felixharnstrom/KMM_2016_Kartrobot/doc/projektplan/tidsplanering.pdf

AKTIVITETER | TID | VEM | TIDPLAN (när), veckonummer
| Beskrivning
| Designspecifikation
| Protokoll mellan PC och robot
| PWM gränssnitt
| UART gränssnitt
| Gränssnitt för blåtandskommunikation
| Upprätta ett dataflöde mellan sensormodulen och sensorerna
| Implementera sensormätning för LIDAR
| Motorstyrning i styrmodul
| Servostyrning LIDAR-torn
| Gränssnitt mellan kontroll- och styrmodul
| Hantering och bearbetning av sensordata
| Protokoll och högnivåkommandon mellan kontroll- och styrmodul
| Test av sensormodul
| Gränssnitt mellan kontroll- och sensormodul
| Test av styrmodul
| Synka diagnostisk data från kommunikationsmodul till PC
| Filtrera mätvärden
| Implementation av manuell styrning
| Styralgoritm
| GUI till PC
| Rumsavskanning från stillastående
| Testa styralgoritm
| Test av GUI
| GUI karta
| Kartalgoritm
| Test av kartalgoritm och autonom styrning
| Navigeringsalgoritm (autonom styrning)
| Test av system
| Optimering
| Teknisk dokumentation
| Användarmanual
| Muntlig presentation (förberedelser)
Nr | timmar | Initialer | 38 | 39 | 40 | 41 | 42 | 43 | 44 | 45 | 46 | 47 | 48 | 49 | 50 | 51 | Sa
1 | 80 | Alla | | | 40 | 40 | O | | | | | | | | | | 80
2 | 10 | MV | | | | | M | | 10 | | | | | | | | 10
3 | 15 | DOK, HV | | | | | T | T | 15 | | | | | | | | 15
4 | 15 | PL, TST | | | | | E | E | 15 | | | | | | | | 15
5 | 10 | MV | | | | | N | N | 10 | | | | | | | | 10
6 | 15 | LEV | | | | | T | T | 15 | | | | | | | | 15
7 | 10 | DOK, HV | | | | | A | A | 10 | | | | | | | | 10
8 | 10 | DOK, HV | | | | | - | - | 10 | | | | | | | | 10
9 | 10 | DOK, HV | | | | | P | P | 10 | | | | | | | | 10
10 | 10 | PL, TST | | | | | | | 10 | | | | | | | | 10
11 | 26 | LEV, MV | | | | | | | | 26 | | | | | | | 26
12 | 20 | DOK, HV | | | | | | | | 20 | | | | | | | 20
13 | 10 | LEV, MV | | | | | | | | 10 | | | | | | | 10
14 | 15 | PL, TST | | | | | | | | 15 | | | | | | | 15
15 | 10 | DOK, HV | | | | | | | | 10 | | | | | | | 10
16 | 20 | PL, TST | | | | | | | | 20 | | | | | | | 20
17 | 15 | DOK, HV | | | | | | | | 10 | 5 | | | | | | 15
18 | 30 | DOK, HV, PL, MV | | | | | | | | | 30 | | | | | | 30
19 | 40 | DOK, HV, PL, MV | | | | | | | | | 40 | | | | | | 40
20 | 20 | LEV, TST | | | | | | | | | 18 | | 2 | | | | 20
21 | 40 | LEV, TST | | | | | | | | | 10 | 30 | | | | | 40
22 | 20 | DOK, HV | | | | | | | | | | 20 | | | | | 20
23 | 10 | DOK, MV | | | | | | | | | | 10 | | | | | 10
24 | 20 | PL, MV | | | | | | | | | | 20 | | | | | 20
25 | 50 | PL, HV | | | | | | | | | | 20 | 30 | | | | 50
26 | 30 | DOK, LEV | | | | | | | | | | | 30 | | | | 30
27 | 70 | MV, TST, PL | | | | | | | | | | | 30 | 40 | | | 70
28 | 40 | HV, DOK, LEV | | | | | | | | | | | | 40 | | | 40
29 | 20 | Alla | | | | | | | | | | | | 10 | 10 | | 20
30 | 64 | Alla | | | | | | | | | | | | 30 | 34 | | 64
31 | 30 | Alla | | | | | | | | | | | | | 30 | | 30
32 | 20 | Alla | | | | | | | | | | | | | | 20 | 20
33 | | | | | | | | | | | | | | | | | 0
34 | 95 | | | | | | | | 9 | 9 | 14 | 14 | 14 | 20 | 10 | 5 | 95
35 | | | | | | | | | | | | | | | | | 0
36 | | | | | | | | | | | | | | | | | 0
37 | 60 | Alla | | | 6 | 6 | | | 6 | 6 | 6 | 6 | 6 | 6 | 6 | 6 | 60
38 | | | | | | | | | | | | | | | | | 0
39 | | | | | | | | | | | | | | | | | 0
40 | | | | | | | | | | Fr | | | | | | | 0
41 | | | | | | | | | | | Fr | | | | | | 0
42 | | | | | | | | | | | | Fr | | | | | 0
43 | | | | | | | | | | | | | | On | | | 0
44 | | | | | | | | | | | | | | | | | 0
45 | | Alla | | | | | | | fr | | | | | | | | 0
46 | | | | | | | | | | | | | | | | | 0
47 | | TST, HV, MV | | | | | | | | | | | | | fr | | 0
48 | | PL, LEV, MV | | | | | | | | | | | | | | to | 0
49 | | | | | | | | | | | | | | | | | 0
50 | | | | | | | | | | | | | | | | | 0
51 | | | | | | | | | | | | | | | | | 0
| | 0 | 0 | 46 | 46 | 0 | 0 | 120 | 126 | 123 | 120 | 112 | 146 | 90 | 31 | 0 | 0 | 0 | 0 | 0 | 0 | 0 | 0 | 0
Summa antal timmar: | 960 | | | | | | | | | | | | | | | | | | | | | | | | 960

Beslutspunkt 3
Beslutspunkt 4 (Används ej) Beslutspunkt 5
Beslutspunkt 6

Projektmöten

Milstolpe 1: Roboten kan köra framåt (röra sig) Milstolpe 2: Roboten kan styras manuellt Milstolpe 3: Roboten kan köras autonomt Milstolpe 4: Roboten uppfyller kravspecen

Reservtid

Mattias Krysander | Version: | 1.0 | Felix Härnström 2016-09-24

## PLANERING

Projekt: | Kartrobot
Projektgrupp: | 1
Datum: | 2016-09-24 | Granskad:
Kurs: | TSEA29 | Utfärdare: | DM, EN, FH

Beställare:
