felixharnstrom/KMM_2016_Kartrobot/doc/projektplan/projektplan.tex

\documentclass[a4paper,11pt]{article}

\usepackage[utf8]{inputenc}
\usepackage[swedish]{babel}
\usepackage[top=1in,bottom=1in,left=1in,right=1in,headsep=.5in]{geometry}
\usepackage{hyperref}
\usepackage{graphicx}
\usepackage{longtable}
\usepackage{pdfpages}

\usepackage{array}
\newcolumntype{L}[1]{>{\raggedright\let\newline\\\arraybackslash\hspace{0pt}}m{#1}}
\newcolumntype{C}[1]{>{\centering\let\newline\\\arraybackslash\hspace{0pt}}m{#1}}
\newcolumntype{R}[1]{>{\raggedleft\let\newline\\\arraybackslash\hspace{0pt}}m{#1}}

\usepackage[yyyymmdd,hhmmss]{datetime}
\renewcommand{\dateseparator}{-}

\usepackage{mathptmx}    %Times Roman font
\usepackage{helvet}    %Helvetica, served as a model for arial
\usepackage{anyfontsize}

\usepackage[tocgraduated]{tocstyle}
\usetocstyle{allwithdot}

\usepackage[titletoc,title]{appendix}

\usepackage[backend=bibtex,style=authoryear,maxcitenames=2,maxbibnames=9]{biblatex}		%Harvard-style citations
\setlength{\bibitemsep}{\baselineskip}	%vertical space between bibliography items

\usepackage{fancyhdr}
\fancypagestyle{intro}{
    \fancyhf{}
    \fancyhead[C]{\LIPSprojekttitel}
    \fancyhead[R]{\today} 
    \fancyfoot[L]{\LIPSkursnamn \\ \LIPSdokumenttyp}
    \fancyfoot[C]{\phantom{text}\roman{page}}
    \fancyfoot[R]{\LIPSprojektgrupp \\ \LIPSgruppepost} 
    \renewcommand{\headrulewidth}{0.4pt}
    \renewcommand{\footrulewidth}{0.4pt}}
\fancypagestyle{content}{
    \fancyhf{}
    \fancyhead[C]{\LIPSprojekttitel}
    \fancyhead[R]{\today} 
    \fancyfoot[L]{\LIPSkursnamn \\ \LIPSdokumenttyp}
    \fancyfoot[C]{\phantom{text}\thepage}
    \fancyfoot[R]{\LIPSprojektgrupp \\ \LIPSgruppepost} 
    \renewcommand{\headrulewidth}{0.4pt}
    \renewcommand{\footrulewidth}{0.4pt}}

\usepackage{titlesec}
\titleformat{\section}
{\normalfont\sffamily\Large\bfseries}
{\thesection}{1em}{}
\titleformat{\subsection}
{\normalfont\sffamily\large\bfseries}
{\thesubsection}{1em}{}
\titleformat{\subsubsection}
{\normalfont\sffamily\bfseries}
{\thesubsubsection}{1em}{}

\newcommand{\LIPSartaltermin}{2016/HT}
\newcommand{\LIPSkursnamn}{TSEA29}
\newcommand{\LIPSprojekttitel}{Kartrobot}
\newcommand{\LIPSprojektgrupp}{Grupp 1}
\newcommand{\LIPSgruppepost}{\href{mailto:kmm_2016_grupp1@liuonline.onmicrosoft.com}{{\small kmm\_2016\_grupp1@liuonline.onmicrosoft.com}}}
\newcommand{\LIPSkund}{ISY, Linköpings universitet, 581\,83 Linköping}
\newcommand{\LIPSkundkontakt}{Mattias Krysander, 013-282198, matkr@isy.liu.se}
\newcommand{\LIPSkursansvarig}{Tomas Svensson, 013-281368, Tomas.Svensson@liu.se}
\newcommand{\LIPShandledare}{Olov Andersson, 013-282658, olov@isy.liu.se}
\newcommand{\LIPSdokumenttyp}{Projektplan}
\newcommand{\LIPSredaktor}{Felix Härnström}
\newcommand{\LIPSversion}{1.0}
\newcommand{\LIPSgranskare}{Silas Lenz}
\newcommand{\LIPSgranskatdatum}{2016-09-24}
\newcommand{\LIPSgodkannare}{}
\newcommand{\LIPSgodkantdatum}{}

\addbibresource{bibliography.bib}
\input{LIPS.tex}
\begin{document}

\pagestyle{intro}
\LIPStitelsida
\clearpage
\begin{LIPSprojektidentitet}
	\LIPSgruppmedlem{Hannes Haglund}{Designansvarig mjukvara (MV)}{hanha265@student.liu.se}
	\LIPSgruppmedlem{Felix Härnström}{Projektledare (PL)}{felha423@student.liu.se}
	\LIPSgruppmedlem{Jani Jokinen}{Leveransansvarig (LEV)}{janjo273@student.liu.se}
	\LIPSgruppmedlem{Silas Lenz}{Testansvarig (TST)}{sille914@student.liu.se}
	\LIPSgruppmedlem{Daniel Månsson}{Designansvarig hårdvara (HV)}{danma344@student.liu.se}
	\LIPSgruppmedlem{Emil Norberg}{Dokumentansvarig (DOK)}{emino969@student.liu.se}
\end{LIPSprojektidentitet}
\clearpage
\renewcommand{\familydefault}{\sfdefault}	%Sans-serif
\normalfont
\tableofcontents
\renewcommand{\familydefault}{\rmdefault}	%Back to serifs
\normalfont
\clearpage
\begin{LIPSdokumenthistorik}
    \LIPSversionsinfo{1.0}{2016-09-24}{Upphöjt till version 1.0}{FH, DM}{SL}
	\LIPSversionsinfo{0.1}{2016-09-22}{Första utkastet}{FH, JJ, SL}{EN}
\end{LIPSdokumenthistorik}
\clearpage
\setcounter{page}{1}
\pagestyle{content}
\section{Beställare}
Beställare är Mattias Krysander från ISY vid Linköpings universitet.

\section{Översiktlig beskrivning av projektet}
\subsection{Syfte och mål}
Projektets mål är att utefter givet projektdirektiv och med beställaren överenskommen kravspecifikation utveckla en robot som kan genomsöka och kartlägga ett enkelt rum. Utöver roboten ska en medföljande PC-mjukvara levereras som kan styra roboten och visa realtidsdata såsom diagnostik och kartan över rummet.

\subsection{Leveranser}
LEV ansvarar för att alla leveranser sker inom utsatt tid. 

\begin{flushleft}
	\begin{LIPSleveransplan}
		\LIPSplaneradleverans{Projektplan, tidsplan, och systemskiss}{PL}{Första version av projektplan, tidsplan, och systemskiss}{2016-09-22}
		\LIPSplaneradleverans{Projektplan, tidsplan, och systemskiss}{PL}{Slutgiltig version av projektplan, tidsplan, och systemskiss}{2016-09-30}
		\LIPSplaneradleverans{Tidrapport}{PL}{Tidrapport 1.}{2016-10-31}
		\LIPSplaneradleverans{Designspecifikation}{MV, HV}{Första version av designspecifikationen.}{2016-11-01}
		\LIPSplaneradleverans{Designspecifikation}{MV, HV}{Slutgiltig version av designspecifikation.}{2016-11-04}
		\LIPSplaneradleverans{Tidrapport}{PL}{Tidrapport 2.}{2016-11-7}
		\LIPSplaneradleverans{Tidrapport}{PL}{Tidrapport 3.}{2016-11-14}
		\LIPSplaneradleverans{Tidrapport}{PL}{Tidrapport 4.}{2016-11-21}
		\LIPSplaneradleverans{Tidrapport}{PL}{Tidrapport 5.}{2016-11-28}
		\LIPSplaneradleverans{Tidrapport}{PL}{Tidrapport 6.}{2016-12-5}
		\LIPSplaneradleverans{Tidrapport}{PL}{Tidrapport 7.}{2016-12-12}
		\LIPSplaneradleverans{Teknisk dokumentation och användarhandledning}{DOK}{Teknisk dokumentation och användarhandledning ska vara inlämnad.}{3 arbetsdagar före redovisning.}
		\LIPSplaneradleverans{Verifiering av kraven (BP5).}{TST}{Tillsammans med beställaren fattas beslut huruvida projektet har nått målet.}{Senast dagen innan redovisning.}
		\LIPSplaneradleverans{Tidrapport}{PL}{Tidrapport 8.}{2016-12-19}
		\LIPSplaneradleverans{Slutpresentation}{PL}{Muntlig presentation av projektet.}{2016-12-19}
		\LIPSplaneradleverans{Tävlingsdeltagande}{PL}{Tävla mot andra robotar som har byggts i kursen.}{2016-12-20}
		\LIPSplaneradleverans{Efterstudie}{PL}{Efterstudie ska lämnas till beställaren.}{2016-12-21}
		\LIPSplaneradleverans{Källkod}{MV}{Källkod ska lämnas till beställaren.}{2016-12-21}
		\LIPSplaneradleverans{Utrustning}{HV}{All utrustning ska återlämnas.}{2016-12-22}
	\end{LIPSleveransplan}
\end{flushleft}

\subsection{Begränsningar}
Produkten är vid slutleverans begränsad till de krav som är formulerade i den senaste versionen av kravspecifikationen. Kravspecifikationen kan inte uppdateras utan överenskommelse med beställaren.

\section{Fasplan}
\subsection{Före projektstart}
Innan påbörjad projektstart ska en kravspecifikation tas fram med utgång i projektdirektivet. Ansvarsområden ska bestämmas internt inom projektgruppen. Projektgruppen ska producera en projektplan, tidsplan, samt systemskiss utefter givna resurser.

\subsection{Under projektet}
I början av denna fas ska en designspecifikation tas fram och godkännas av beställare. Under projektets gång ska projektgruppen utgå från designspecifikationen och se till att överenskomna leveranser sker tidsenligt. Projektet ska utföras enligt LIPS-modellen.

\subsection{Efter projektet}
Efter beslutspunkt 5 ska produkten levereras med tillhörande dokumentation. Beställaren utför acceptanstest i samband med en tävling där alla robotar som har producerats utefter samma projektdirektiv ska ställa upp. En efterstudie ska därefter levereras.

\section{Organisationsplan för hela projektet}
Projektgruppen och utomstående resurser är organiserade såsom beskrivet i figur \ref{fig:org}. Utöver denna grova organisationsplan kan projektgruppen bilda interna arbetsgrupper vid behov.

\begin{figure}[h!]
	\centering
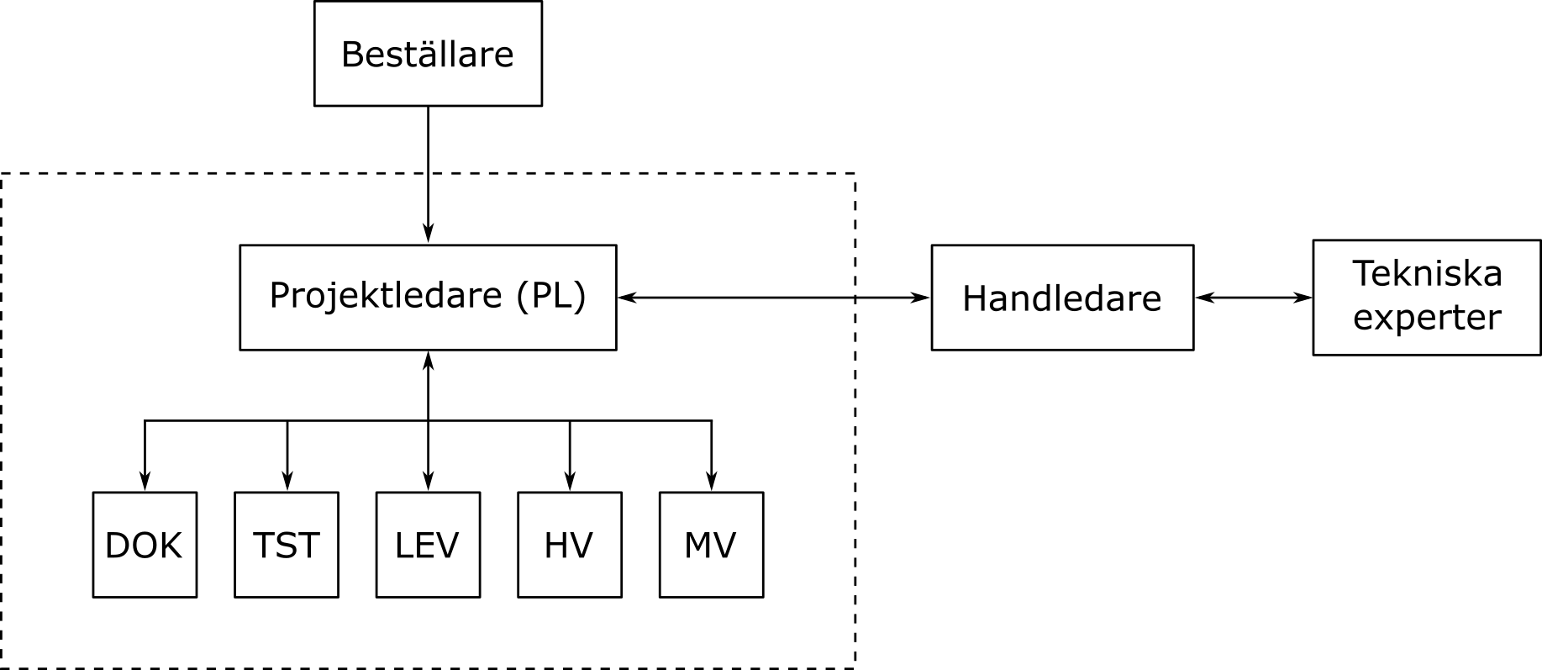
[picture p23: doc/projektplan/organisation.png]
	
	\caption{Översiktlig projektorganisation.}
	\label{fig:org}
\end{figure}

\subsection{Villkor för samarbetet inom projektgruppen}
Följande punkter har beslutats gemensamt av projektgruppen och ska anses vara riktlinjer för hur samarbetet inom gruppen ska ske. Övriga frågor ska tas upp internt på gruppmöten.

\begin{itemize}
	\item Deltagarna i gruppen ska gemensamt göra upp ordningsregler för gruppen om tider, närvaro, förberedelser, etc.
	\item Alla deltagare i gruppen ska delta vid de tillfällen som gruppen kommit överens om.
	\item Alla deltagare i gruppen ska komma väl förberedda till möten och dylikt, i den mån att det är nödvändigt för gruppens fortsatta arbete.
	\item Alla deltagare i gruppen förväntas självständigt kommunicera med övriga gruppmedlemmar och arbetsgrupper för att underlätta sina egna och övrigas arbetsuppgifter.
	\item Alla deltagare i gruppen ska ha en professionell inställning till arbetet som ska utföras.
	\item Alla deltagare i gruppen kan ta upp interpersonella konflikter och frågor på möten för att säkerställa ett hälsosamt samarbete.
	\item Problem med deltagare som inte bidrar till det gemensamma arbetet ska i första hand lösas internt, men kan vidarebefordras till kurspersonal om problemet kvarstår.
	\item Alla deltagare i gruppen ska vara öppna för konstruktiv kritik.
	\item Grupparbetet ska prioritera intresse framför resultat. En gruppmedlem ska inte vara tvingad att arbeta med någon visst område enbart för att vederbörande är den bäst lämpade för arbetet.
	\item Vid schemalagda arbetstillfällen och projektmöten ska 'akademisk kvart' tillämpas.
	\item Alla deltagare i gruppen har möjlighet att jobba hemifrån utefter eget schema efter samröre med berörda gruppmedlemmar.
	\item Alla deltagare i gruppen ska vara kontaktbara under schemalagd arbetstid.
\end{itemize}

\subsection{Definition av arbetsinnehåll och ansvar}
\subparagraph{Projektledare (PL)}
\begin{itemize}
\item Ansvarig för kontakt mellan gruppen och beställaren samt handledaren.
\item Ansvarar för att uppdatera och i tid skicka in tidsrapporterna.
\item Ska se till att mötesplanen följs och kallar till varje möte.
\item Ska fördela arbetsuppgifter internt.
\item Ska hålla en överblick över projektet och se till att alla gruppmedlemmar jobbar mot samma mål.
\end{itemize}

\subparagraph{Leveransansvarig (LEV)}
\begin{itemize}
\item Ansvarig för att alla leveranser sker inom utsatt tid.
\item Ansvarig för att fördela bufferttid från tidsplanen.
\item Ansvarig för att revidera tidsplanen vid behov.
\item Ska informera alla gruppmedlemmar vid eventuellt behov av att revidera tidsplanen.
\end{itemize}

\subparagraph{Testansvarig (TST)}
\begin{itemize}
\item Ansvarig för att tester utförs.
\item Ansvarig för att producera rutiner för att utföra tester och för att rapportera resultatet av dessa.
\item Ska samarbeta med HV och MV för att utforma integrationstestspecifikation och systemtestspecifikation. 
\end{itemize}

\subparagraph{Dokumentansvarig (DOK)}
\begin{itemize}
\item Ansvarig för att alla dokument som ska levereras följer LIPS-mallar i största möjliga mån.
\item Ska vid behov producera dokumentmallar i fallet att LIPS-mall saknas.
\item Ansvarig för att mötesprotokoll förs.
\item Ska informera alla gruppmedlemmar om gällande stilregler för dokument som ska levereras.
\end{itemize}

\subparagraph{Designansvarig hårdvara (HV)}
\begin{itemize}
\item Ansvarig för övergripande kvalitet på den hårdvara gruppen producerar.
\item Ansvarig för att upprätta rutiner och en standard för hur hårdvarukonstruktionen ska utföras.
\item Ansvarig för att gruppen har de hårdvaruverktyg den behöver.
\item Ska samarbeta med TST för att utforma integrationstestspecifikation och systemtestspecifikation.
\item Ansvarig för att hårdvaran förvaras säkert.
\end{itemize}

\subparagraph{Designansvarig mjukvara (MV)}
\begin{itemize}
\item Ansvarig för övergripande kvalitet på den mjukvara gruppen producerar.
\item Ansvarig för att gruppen har de mjukvaruverktyg den behöver.
\item Ska samarbeta med TST för att utforma integrationstestspecifikation och systemtestspecifikation.
\item Ansvarig för att utforma rutiner för versionshantering av källkod.
\end{itemize}

\section{Dokumentplan}
\label{sec:doc_plan}
Dokument ska i största möjliga mån följa tillgängliga LIPS-mallar. Dokumentansvarig är i fall där LIPS-mall saknas ansvarig för att skapa eller i övrigt godkänna dokumentmallar vid behov. Dokument ska lagras på sådant sätt att alla gruppmedlemmar har tillgång till alla dokument över internet. Alla dokument ska skrivas på svenska, men teknisk dokumentation i källkod bör skrivas på engelska. 

Dokument ska revisionsnumreras på formatet \textit{\textless version\textgreater .\textless utgåva\textgreater}, där versionsnummer under 0 ska anses vara interna utkast, och version 1 är redo för leverans eller arkivering beroende på dokumenttyp. Att tilldela ett nytt versionsnummer innebär stora förändringar till dokumentets väsentliga innehåll. Utgåvenumret betecknar mindre förändringar som inte ändrar dokumentets väsentliga innehåll. Alla nya revisioner efter 1.0 av dokument som ska levereras till beställare måste göras i samröre med denne.

Alla gruppmedlemmar är ansvariga för att all dokumentation denne producerar följer de språkregler som gäller för dokumentspråket såsom beskrivet i tabell \ref{tab:documents}. För svenska gäller språkreglerna såsom beskrivna i \citetitle{Sprakradet2008} (\cite{Sprakradet2008}). För dokument som skrivs på engelska hänvisas till \citetitle{Ritter2003} (\cite{Ritter2003}).

%TODO: Tagit bort syfte och distribueras till. Känns onödigt och förstör tabellen.../SL
\label{tab:documents}
\begin{flushleft}
    \begin{tabular}{|L{90pt}|L{40pt} |L{60pt} |L{100pt} |L{100pt} |}
    	\hline
    	Dokument              & Ansvarig & Godkänns av & Distribueras till   & Färdig                         \\ \hline
    	Systemskiss           & PL       & Beställare  & Beställare, Gruppen & 2016-09-30                     \\ \hline
    	Tidsplan              & PL       & Beställare  & Beställare, Gruppen & 2016-09-30                     \\ \hline
    	Projektplan           & PL       & Beställare  & Beställare, Gruppen & 2016-09-30                     \\ \hline
    	Tidsrapporter         & PL      & Beställare  & Beställare, Gruppen & Måndagar vecka 44 - vecka 51   \\ \hline
    	Uppdaterad tidsplan   & DOK      & Beställare  & Beställare, Gruppen & Måndagar vecka 44 - vecka 51   \\ \hline
    	Designspecifikation   & MV, HV   & Handledare  & Handledare, Gruppen & 2016-11-04                     \\ \hline
    	Teknisk dokumentation & DOK      & Beställare  & Beställare, Gruppen & 3 arbetsdagar före redovisning \\ \hline
    	Användahandledning    & DOK      & Beställare  & Beställare, Gruppen & 3 arbetsdagar före redovisning \\ \hline
    	Efterstudie           & PL       & Beställare  & Beställare, Gruppen & 2016-12-21                     \\ \hline
    \end{tabular}
\end{flushleft}

\section{Utbildningsplan}
\subsection{Egen utbildning}
Alla gruppmedlemmar ska genomföra en laboration i mätteknik, vilket innefattar att lära sig att använda en logikanalysator. Utöver detta förväntas alla gruppmedlemmar egenhändigt söka upp den kunskap och utbildning som krävs för att utföra sina tilldelade arbetsuppgifter.

\section{Rapporteringsplan}
Tidsrapporter kommer att skrivas så att beställaren kan få en bild av hur projektet löper framåt, samt om tidsplanen följs. Se avsnitt \ref{sec:doc_plan} för detaljer om hur tidsrapporter ska utformas och levereras.

\section{Mötesplan}
För alla möten gäller att projektledaren kallar till möte efter samråd om tillfälle med övriga gruppmedlemmar. Mötesprotokoll ska föras utefter LIPS-mallen. Alla gruppmedlemmar kan föra protokoll, men mötesprotokoll måste godkännas av projektledare eller dokumentansvarig.

Regelbundna projektmöten ska ske veckovis, företrädesvis i början av varje vecka. Vid dessa möten ska den gångna veckans arbete redovisas och utvärderas. Vidare ska en plan för grupparbetet fram tills nästa möte beslutas. Dessa möten ska hållas korta, helst under en timme per mötestillfälle. 

Utöver dessa projektmöten kan alla gruppmedlemmar föreslå möten vid behov. Dessa möten kan exempelvis handla om att fånga upp problem så tidigt som möjligt, eller göra en funktionalitets- eller kodgenomgång.

\section{Resursplan}
Här beskrivs vilka personer som jobbar med projektet, samt deras uppgifter. Även ekonomi, lokaler, samt nödvändigt materiel kommer att behandlas i detta kapitel.

\subsection{Personer}
Projektmedlemmarna:
\begin{itemize}
	\item Felix Härnström, Projektledare (PL)
	\item Emil Norberg, Dokumentansvarig (DOK)
	\item Hannes Haglund, Designansvarig mjukvara (MV)
	\item Daniel Månsson, Designansvarig hårdvara (HV)
	\item Silas Lenz, Testansvarig (TST)
	\item Jani Jokinen, Leveransansvarig (LEV)
\end{itemize}
Hannes Haglund kommer att vara bortrest under sista veckan av projektet, från och med den 20:e.

Schemalagd tid är prioriterat för arbete och samtliga deltagare är upptagna under andra kursers föreläsningar och moment.

Handledaren för projektet är Olov Andersson, som under projektets gång kommer vara tillgänglig för rådgivning. Projektgruppen kommer träffa handledaren mindre i början och mer i slutet av projektet.

Beställaren för projektet är  Mattias Krysander på ISY, Linköpings Universitet. Mattias kommer att delta vid alla beslutspunkter.

\subsection{Materiel}
Beställaren förser gruppen med den hård- och mjukvara som krävs för att genomföra projektet. Gruppen kan i samröre med beställare göra förfrågan om att införskaffa ytterligare materiel. 

\subsection{Lokaler}
Gruppen har tillgång till två arbetsstationer i laborationsytan MUXEN och där kan vid behov samtliga 6 medlemmar jobba. Vid behov kan även grupplokaler bokas kostnadsfritt på universitetet.

\subsection{Ekonomi}
Gruppen ska efter beslutspunkt 2 arbeta totalt 960 timmar, 160 timmar per person. Genomfört arbete ska redovisas veckovis till beställaren. Alla monetära utgifter står Linköpings Universitet för.

\section{Milstolpar och beslutspunkter}
I detta kapitel förklaras vilka milstolpar samt beslutspunkter som finns.

\subsection{Milstolpar}
\begin{flushleft}
    \begin{LIPSmilstolpar}
        \LIPSmilstolpe{1}{Roboten kan röra sig framåt.}{2016-11-11}
        \LIPSmilstolpe{2}{Roboten kan styras manuellt.}{2016-11-18}
        \LIPSmilstolpe{3}{Roboten kan köras autonomt.}{2016-11-25}
        \LIPSmilstolpe{4}{Roboten uppfyller kravspecen.}{2016-12-07}
    \end{LIPSmilstolpar}
\end{flushleft}

\subsection{Beslutspunkter}
\begin{flushleft}
	\begin{LIPSbeslutspunkter}
		\LIPSbp{0}{Godkännande av projektet, beslut startar förstudie}{2016-09-01}
		\LIPSbp{1}{Godkännande av kravspecifikation, beslut startar förberedelsefasen}{2016-09-13}
		\LIPSbp{2}{Godkännande av projektplan, tidsplan och systemskiss, beslut startar utförandefasen}{2016-09-30}
		\LIPSbp{3}{Godkännande av designspecifikation, beslut att fortsätta utförandefasen}{2016-11-04}
		\LIPSbp{4}{Används ej}{}
		\LIPSbp{5}{Verifiering av kraven, samt godkännande av produktens funktionalitet, beslut leder till leveransfasen}{Senast en dag innan presentation}
		\LIPSbp{6}{Godkännande av produktleverans, samt presentation och demonstration, leder till beslut att upplösa projektgruppen}{Vecka 51}
	\end{LIPSbeslutspunkter}
\end{flushleft}

\section{Aktiviteter}

\begin{flushleft}
    \begin{LIPSaktivitetslista}
        \LIPSaktivitet{1}{Designspecifikation}{Skriva en fullständig designspecifikation för användning i projektfasen.}{-}{80}
        \LIPSaktivitet{2}{Protokoll mellan PC och robot}{Upprätta protokollet för att överföra data över blåtand mellan PC och robot.}{1}{10}
        \LIPSaktivitet{3}{PWM gränssnitt}{Skriv ett gränssnitt för att kommunicera över PWM och anpassa det även för användning i kommunikation mellan sensormodul och ultraljudssensorer.}{1}{15}
        \LIPSaktivitet{4}{UART gränssnitt}{Skriv ett gränssnitt för att kommunicera över UART.}{1}{15}
        \LIPSaktivitet{5}{Gränssnitt för blåtands-kommunikation}{Implementera funktionalitet för att skicka och behandla kommandon mellan PC och kommunikationsmodul.}{2}{10}
        \LIPSaktivitet{6}{Upprätta ett dataflöde mellan sensormodulen och sensorerna}{Implementera kommunikation mellan sensormodulen och sensorerna.}{3, 7}{15}
        \LIPSaktivitet{7}{Implementera sensormätning för LIDAR}{Implementera funktionalitet så att vi kan läsa av värden från LIDAR-tornets sensor.}{3}{10}
        \LIPSaktivitet{8}{Motorstyrning i styrmodul}{Implementera funktionalitet för att styra vänster och höger motorsida i styrmodulen.}{3}{10}
        \LIPSaktivitet{9}{Servostyrning LIDAR-torn}{Funktionalitet för att styra LIDAR-tornets servo i styrmodulen.}{4}{10}
        \LIPSaktivitet{10}{Gränssnitt mellan kontroll- och styrmodul}{Implementera gränssnitt för USB-UART mellan kontrollmodul och styrmodul.}{4}{10}
        \LIPSaktivitet{11}{Hantering och bearbetning av sensordata}{Kontrollera att den sensordata som fås är vettig för att sedan behandla den och göra den användbar för kontrollmodulen.}{6}{26}
        \LIPSaktivitet{12}{Protokoll och högnivå-kommandon mellan kontroll- och styrmodul}{Implementera styrning av motorerna med hjälp av högnivåkommandon från kontrollmodulen och återkoppla med motordata.}{8, 9, 10}{20}
        \LIPSaktivitet{13}{Test av sensormodul}{Testa och verifiera att mätvärden från sensormodulen är korrekta och användbara för kontrollmodulen.}{11}{10}
        \LIPSaktivitet{14}{Gränssnitt mellan kontroll- och sensormodul}{Implementera gränssnitt för USB-UART mellan kontrollmodul och sensormodul.}{4, 13}{15}
        \LIPSaktivitet{15}{Test av styrmodul}{Testa och verifiera att styrmodulen är pålitlig vid styrning från kontrollenhet.}{12}{10}
        \LIPSaktivitet{16}{Synka diagnostisk data från kommunikationsmodul till PC}{Skriv funktionalitet för att kontinuerligt skicka diagnostisk data från kommunikationsmodul till PC.}{5, 12, 14}{20}
        \LIPSaktivitet{17}{Filtrera mätvärden}{Behandla sensordata i sensormodulen mer ingående för att förhindra felaktiga mätvärden.}{16}{15}
        \LIPSaktivitet{18}{Implementation av manuell styrning}{Möjliggör manuell styrning av roboten med hjälp av blåtandskommandon.}{5, 15}{30}
        \LIPSaktivitet{19}{Styralgoritm}{Autonom styrning för att kunna köra runt i rummet utan att krocka. Följa en vägg. Involverar även att fästa den manuella switchen för att byta mellan det manuella och autonoma körläget.}{18, 14}{40}
        \LIPSaktivitet{20}{GUI till PC}{Presentera diagnostisk data och möjliggör manuell styrning med ändring av parametrar från ett grafiskt användargränssnitt.}{16, 18}{20}
        \LIPSaktivitet{21}{Rumsavskanning från stillastående}{Funktionalitet som stödjer att skanna av rummet och bilda en karta då roboten står still.}{17}{40}
        \LIPSaktivitet{22}{Testning av styralgoritm}{Testa körning av roboten på autonomt läge och kontrollera att den inte krockar med någon vägg.}{19}{20}
        \LIPSaktivitet{23}{Test av GUI}{Kontrollera att GUI:t får korrekt data och är responsivt.}{20}{10}
        \LIPSaktivitet{24}{GUI karta}{Presentera grafiskt det rum som roboten har kartlagt.}{23, 25}{20}
        \LIPSaktivitet{25}{Kartalgoritm}{Funktionalitet för att skanna rummet och bearbeta data så att den blir presentabel och redo för att skickas till en PC.}{21, 22}{50}
        \LIPSaktivitet{26}{Test av kartalgoritm och autonom styrning}{Kontrollera och verifiera att det inte blir outforskade områden i kartan samt att den autonoma styrningen fungerar.}{24, 27}{30}
        \LIPSaktivitet{27}{Navigeringsalgoritm (autonom styrning)}{Utöka den autonoma styrningen med funktionalitet som med utgångspunkt från den befintliga kartan bestämmer vart den ska köra för att skanna mer.}{25}{70}
        \LIPSaktivitet{28}{Test av system}{Utförliga tester av roboten för att säkerställa att dess funktionalitet är pålitlig.}{26}{40}
        \LIPSaktivitet{29}{Optimering}{Optimera och testa roboten inför tävlingen i mån av tid.}{28}{20}
        \LIPSaktivitet{30}{Teknisk dokumentation}{Skriva en fullständig teknisk dokumentation för roboten.}{28}{64}
        \LIPSaktivitet{31}{Användar-manual}{Skriva en manual för hur roboten ska användas för kunden.}{28}{30}
        \LIPSaktivitet{32}{Muntlig presentation}{Förberedelser inför den muntliga presentationen av roboten.}{28}{20}
    \end{LIPSaktivitetslista}
\end{flushleft}
\section{Tidplan}
Se bilaga \ref{app:tidplan}.

\section{Förändringsplan}
% TODO: Kanske nämna leveransansvarigs roll i detta
Om projektet inte kan hålla den fastslagna tidsplanen ska tidsplanen revideras och projektgruppen ska ta interna åtgärder för att säkerställa tidsenliga leveranser trots förseningen. Beslut om reviderad tidsplan ska ske vid varje veckomöte. Om en försening riskerar att försena en leverans ska detta diskuteras med beställaren.

\section{Kvalitetsplan}
I denna sektion beskrivs rutiner gällande granskningar av dokument och tester som ska utföras på den hård- och mjukvara som produceras under projektets gång. Dessa aktiviteter ska utföras löpande under projektets gång för att minimera oförutsedda problem.

\subsection{Granskningar}
Alla dokument som ska levereras till beställare ska granskas av någon annan gruppmedlem än dokumentets redaktör såsom specificerat i sektion \ref{sec:doc_plan}. I första hand ska granskningen utföras av en gruppmedlem som har arbetat med sakfrågan som beskrivs i dokumentet.

\subsection{Testplan}
Alla gruppmedlemmar är ansvariga för att själva utföra enhetstester på all hård- och mjukvara som denne producerar. Testansvarig är ansvarig för att detta efterföljs och att det finns rimliga testprotokoll för alla delar av projektet. Testansvarig ska också säkerställa att det finns rutiner för hur misslyckade tester ska utvärderas och rapporteras. Testansvarig ska i samarbete med hårdvaruansvarig och mjukvaruansvarig utforma relevant integrationstestspecifikation och systemtestspecifikation.

\section{Prioriteringar}
I fallet att projektet drabbas av tidsnöd som riskerar att påverka tidsenliga leveranser ska detta i första hand diskuteras internt inom gruppen. Om en konkret handlingsplan för att säkerställa tidsenliga leveranser ej kan fastställas ska beställaren kontaktas för en dialog om att revidera kravspecifikationen.

\section{Projektavslut}
Projektet avslutas med en presentation av vår kartrobot, samt uppvisning av den i form av ett tävlingsdeltagande. Därefter ska allt material återlämnas till handledare. Dokumentationen ska lämnas till Linköpings Universitet för förvaring och alla medlemmar i gruppen få egna kopior för privat förvaring. När projektet är avslutat ska det utvärderas inom gruppen innan gruppen officiellt upplöses.

\clearpage

\begin{appendices}
\includepdf[scale=1.2,offset=45pt 100pt,pagecommand=\section{Tidplan}\label{app:tidplan}]{tidsplanering.pdf}
\end{appendices}
\clearpage
\addcontentsline{toc}{section}{Referenser}	%append references section at this location to TOC
\printbibliography
\end{document}
