felixharnstrom/KMM_2016_Kartrobot/doc/tek_dok/autonomt_flowchart.png

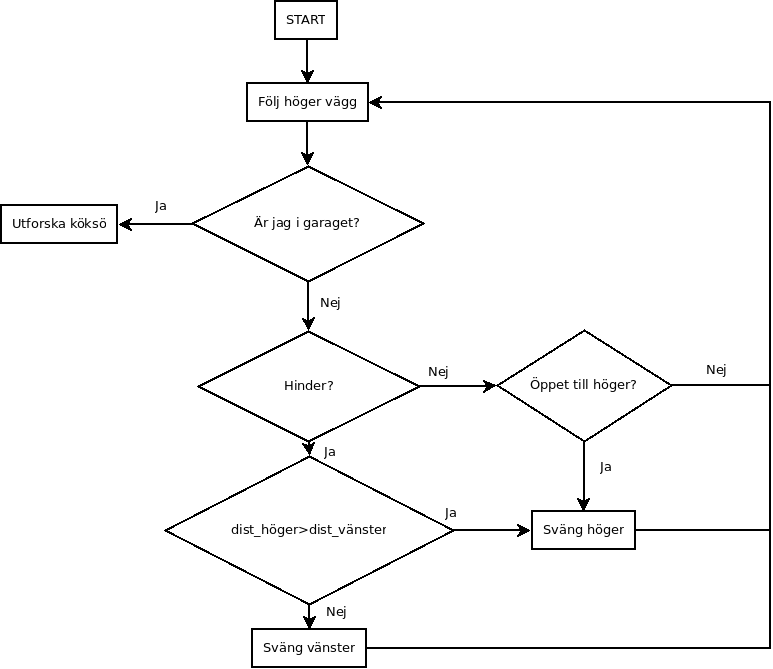
doc/tek_dok/autonomt_flowchart.png
