felixharnstrom/KMM_2016_Kartrobot/doc/tek_dok/layout_topdown.png

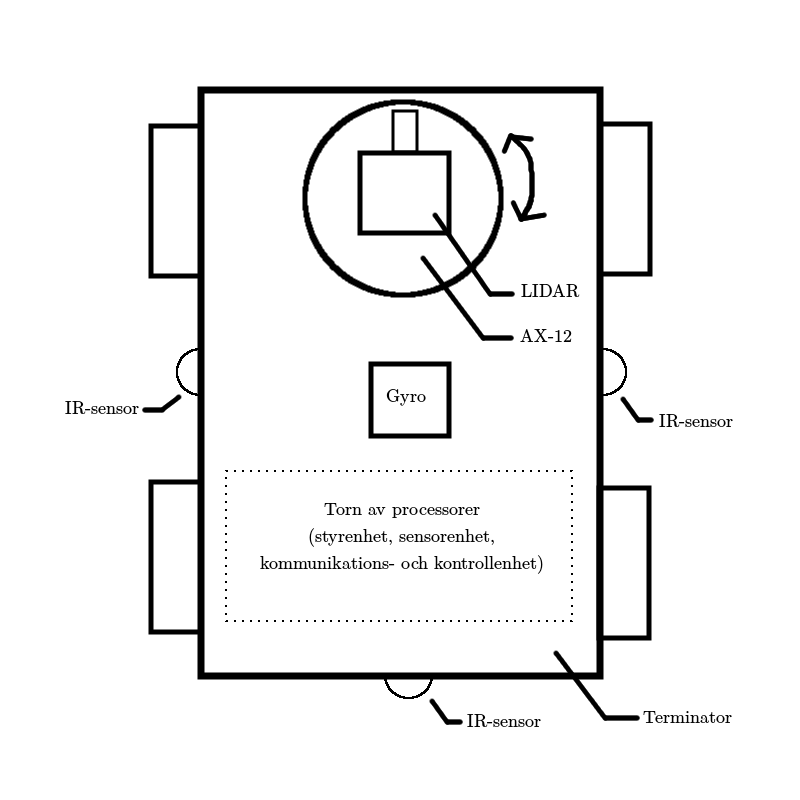
doc/tek_dok/layout_topdown.png
