felixharnstrom/KMM_2016_Kartrobot/doc/tek_dok/robot_overview.JPG

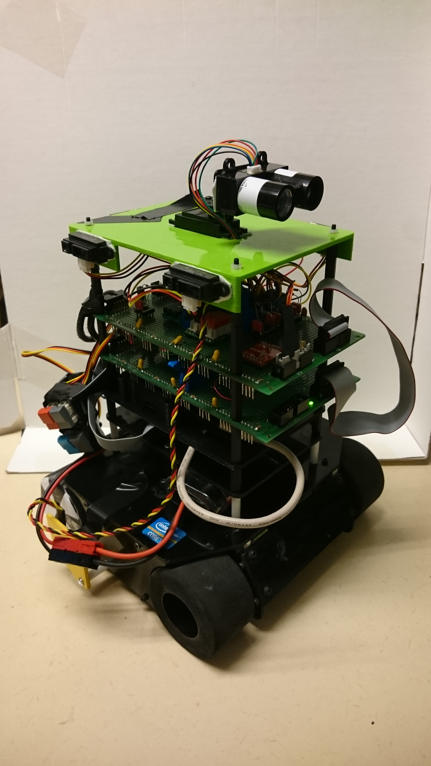
doc/tek_dok/robot_overview.JPG
