felixharnstrom/KMM_2016_Kartrobot/doc/tek_dok/robot_side.JPG

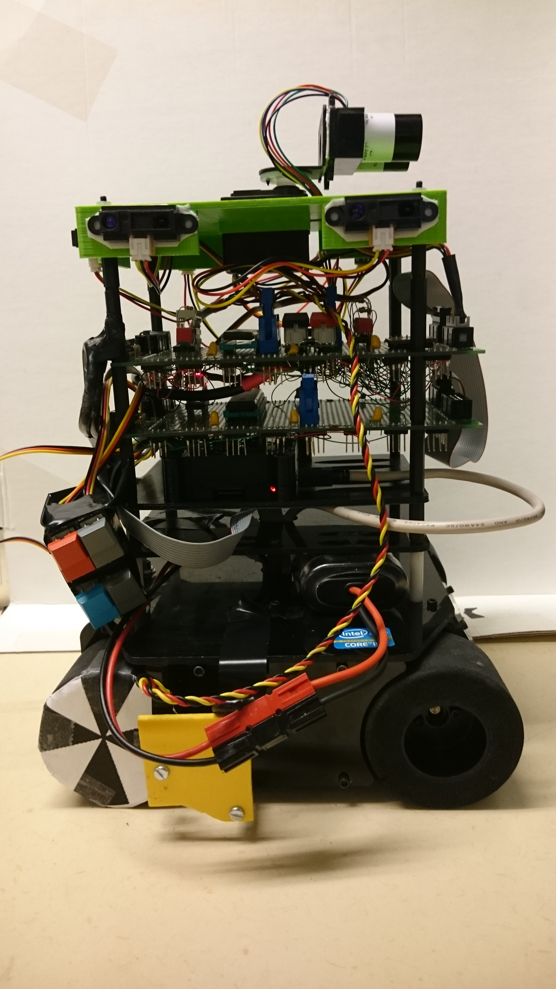
doc/tek_dok/robot_side.JPG
