felixharnstrom/KMM_2016_Kartrobot/doc/tek_dok/sensorenheten-flow_chart.jpg

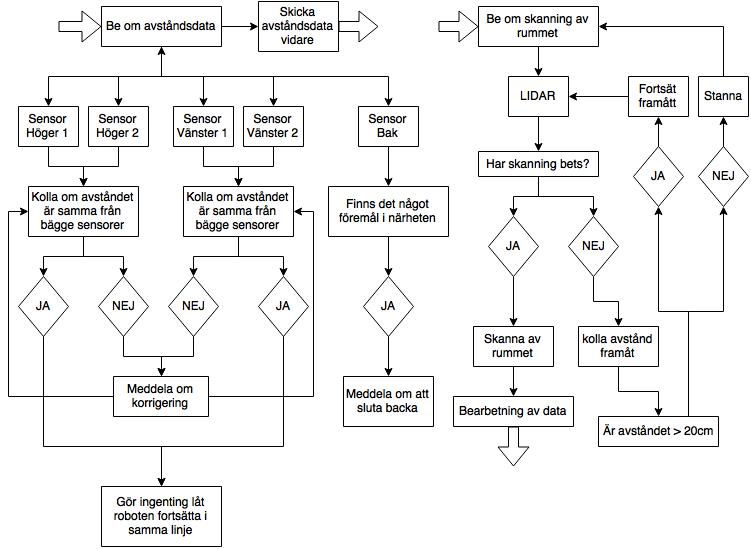
doc/tek_dok/sensorenheten-flow_chart.jpg
