felixharnstrom/KMM_2016_Kartrobot/doc/tek_dok/sensorenheten-flow_chart.png

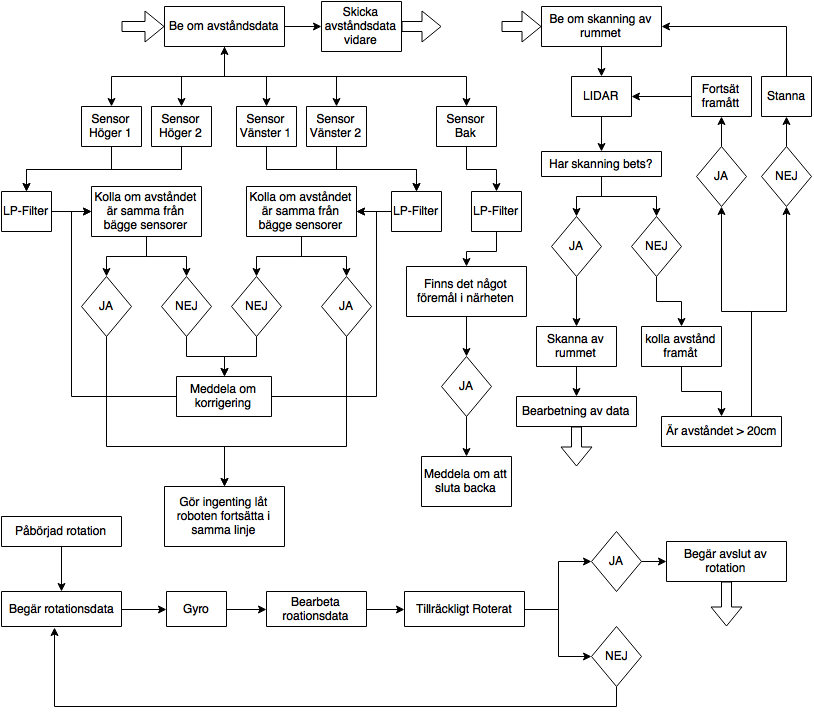
doc/tek_dok/sensorenheten-flow_chart.png
