felixharnstrom/KMM_2016_Kartrobot/doc/tek_dok/sensorer.jpg

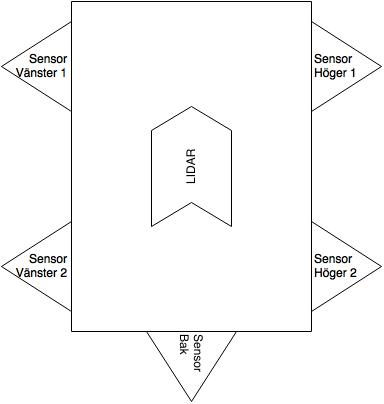
doc/tek_dok/sensorer.jpg
