felixharnstrom/KMM_2016_Kartrobot/doc/tek_dok/styrenhet-flowchart.png

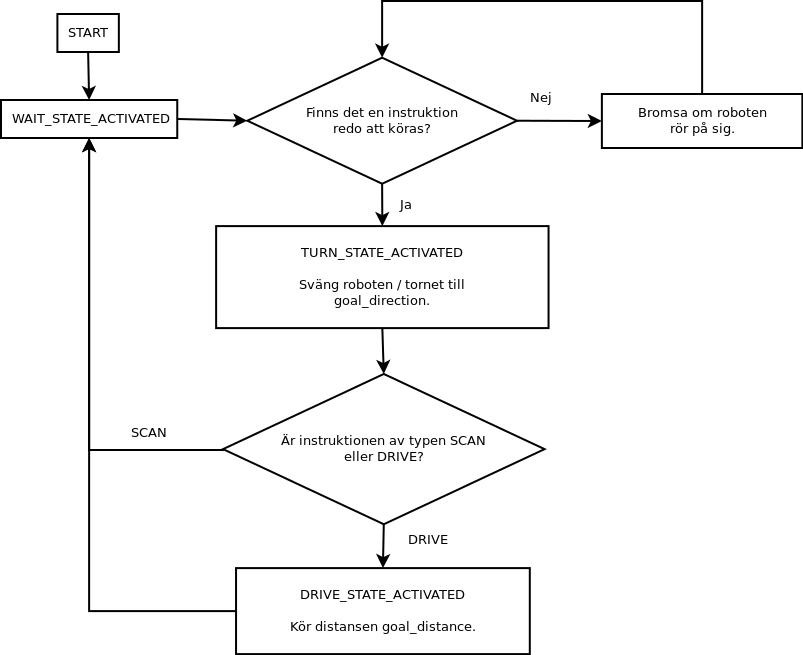
doc/tek_dok/styrenhet-flowchart.png
