felixharnstrom/KMM_2016_Kartrobot/doc/user_manual/gui.png

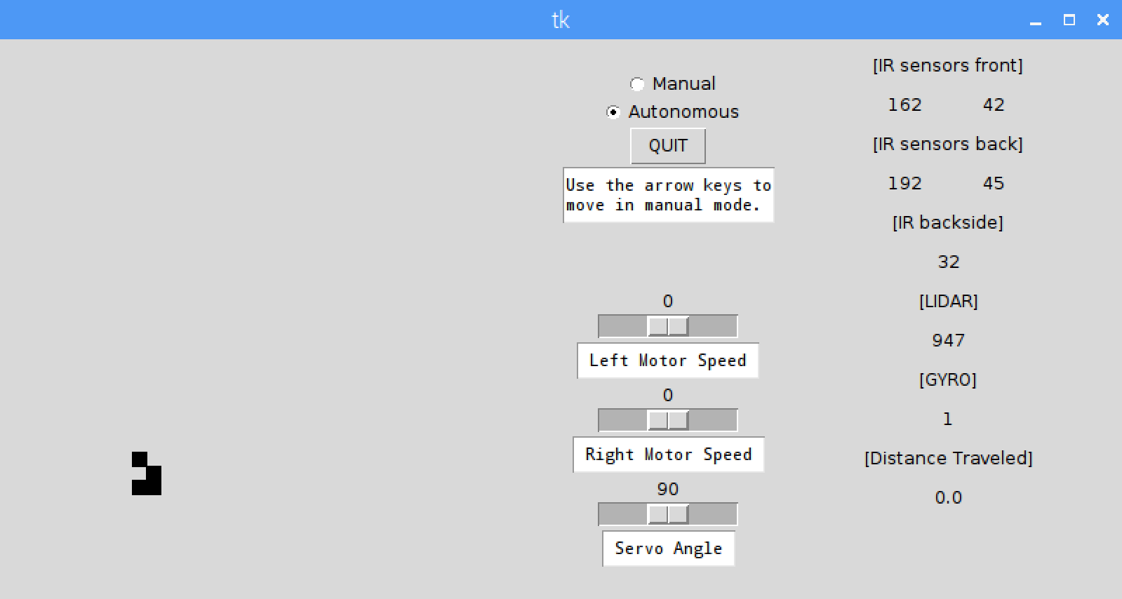
doc/user_manual/gui.png
