felixharnstrom/KMM_2016_Kartrobot/doc/user_manual/gui_reflex.PNG

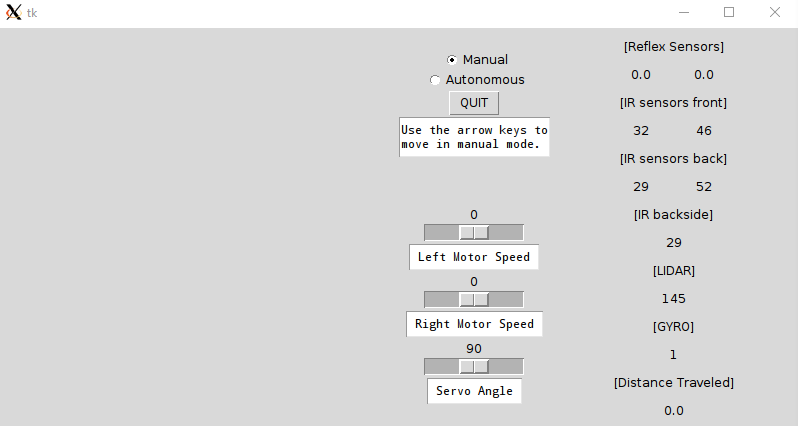
doc/user_manual/gui_reflex.PNG
