felixharnstrom/KMM_2016_Kartrobot/doc/tek_dok/schematics/sensorenhet/kicad.pdf

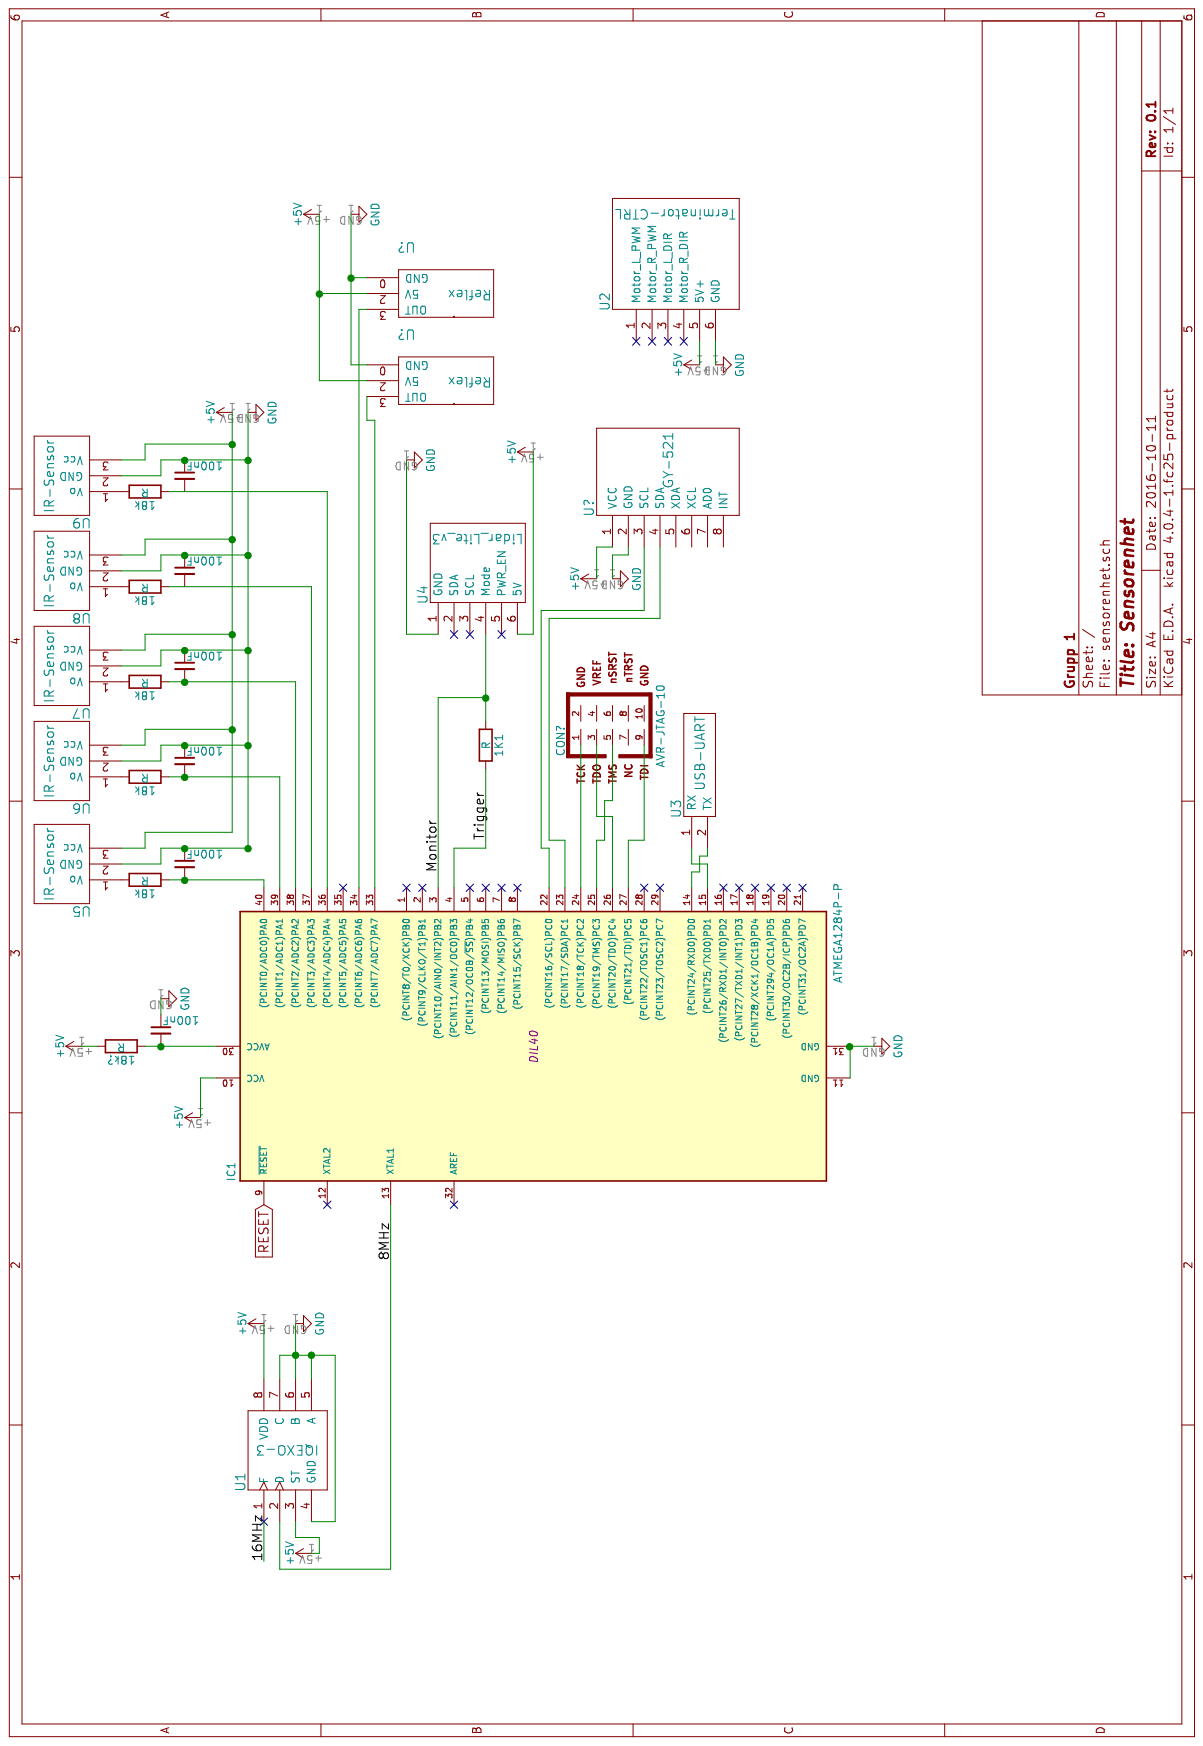
[picture p34: page 1]
