felixharnstrom/KMM_2016_Kartrobot/doc/tek_dok/schematics/styrenhet/kicad.pdf

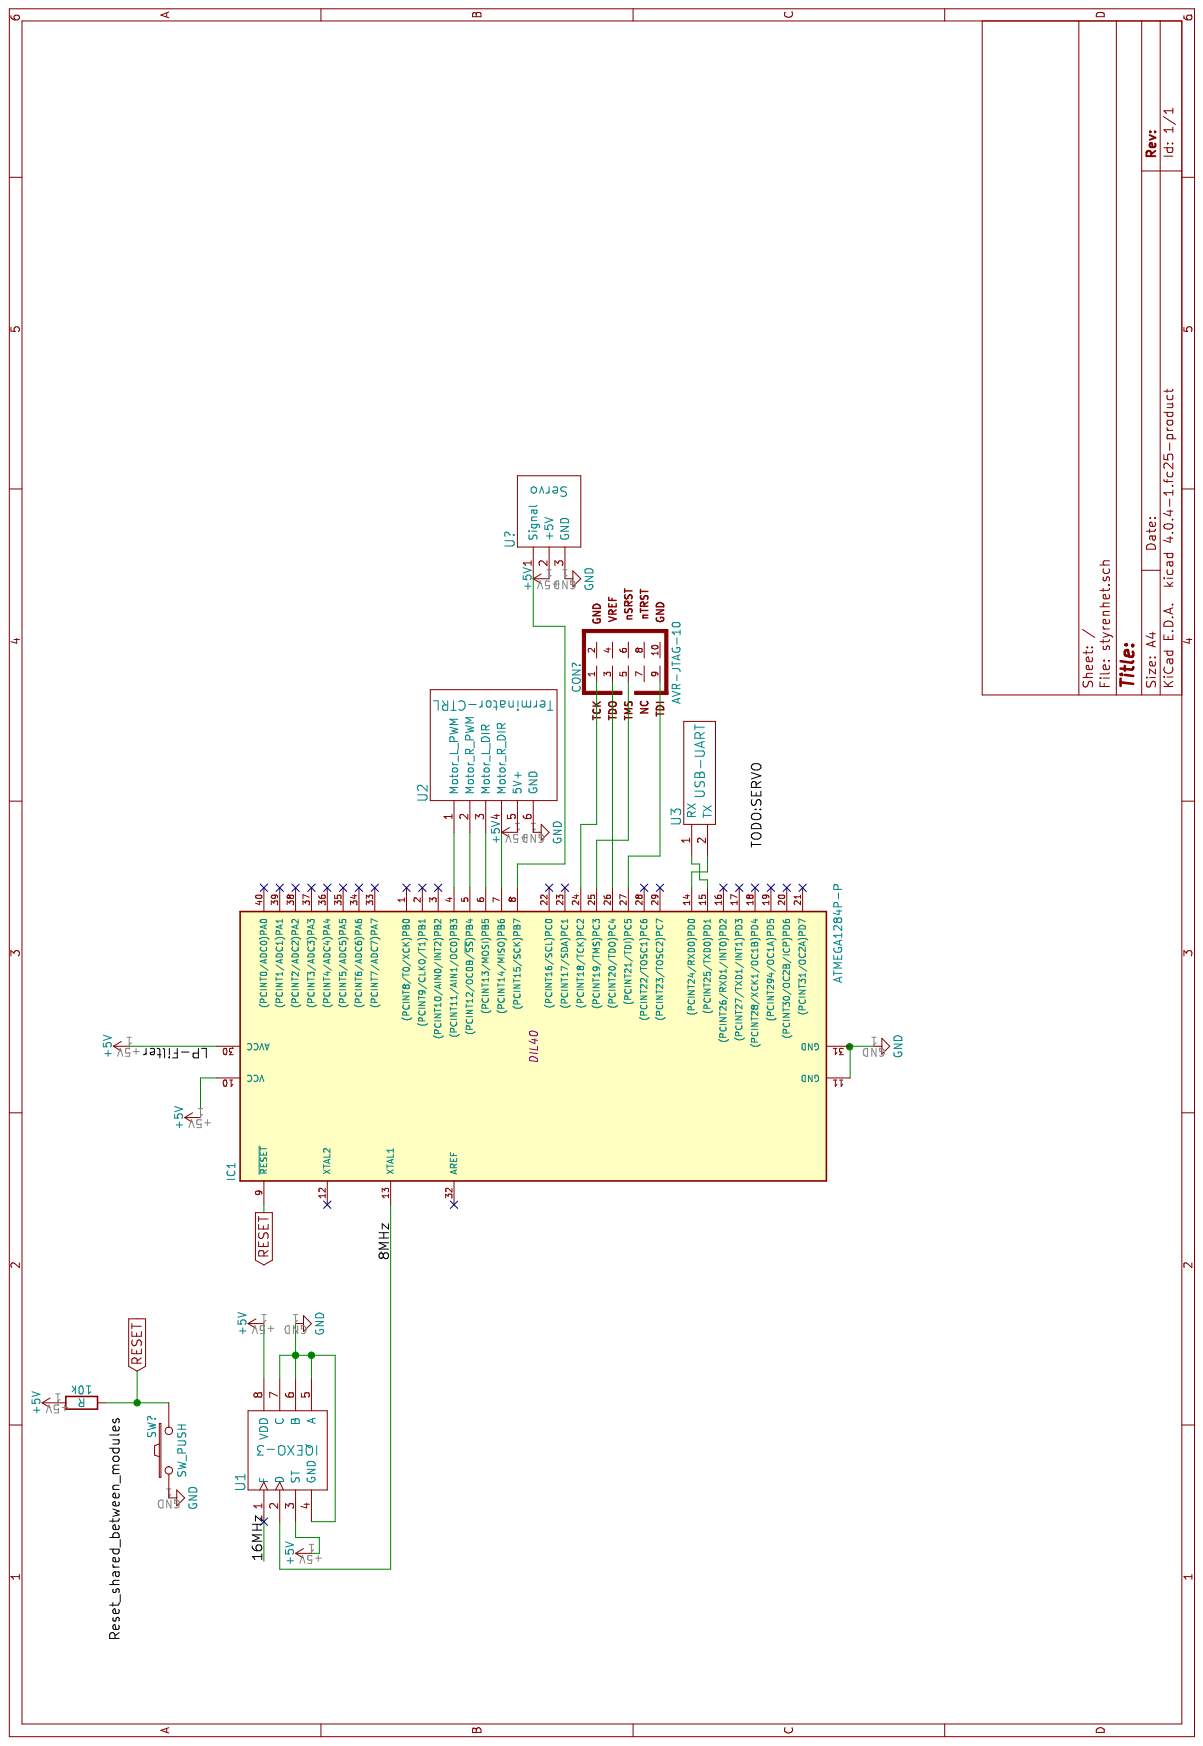
[picture p35: page 1]
