felixharnstrom/KMM_2016_Kartrobot/doc/tek_dok/schematics/brain/kicad.pdf

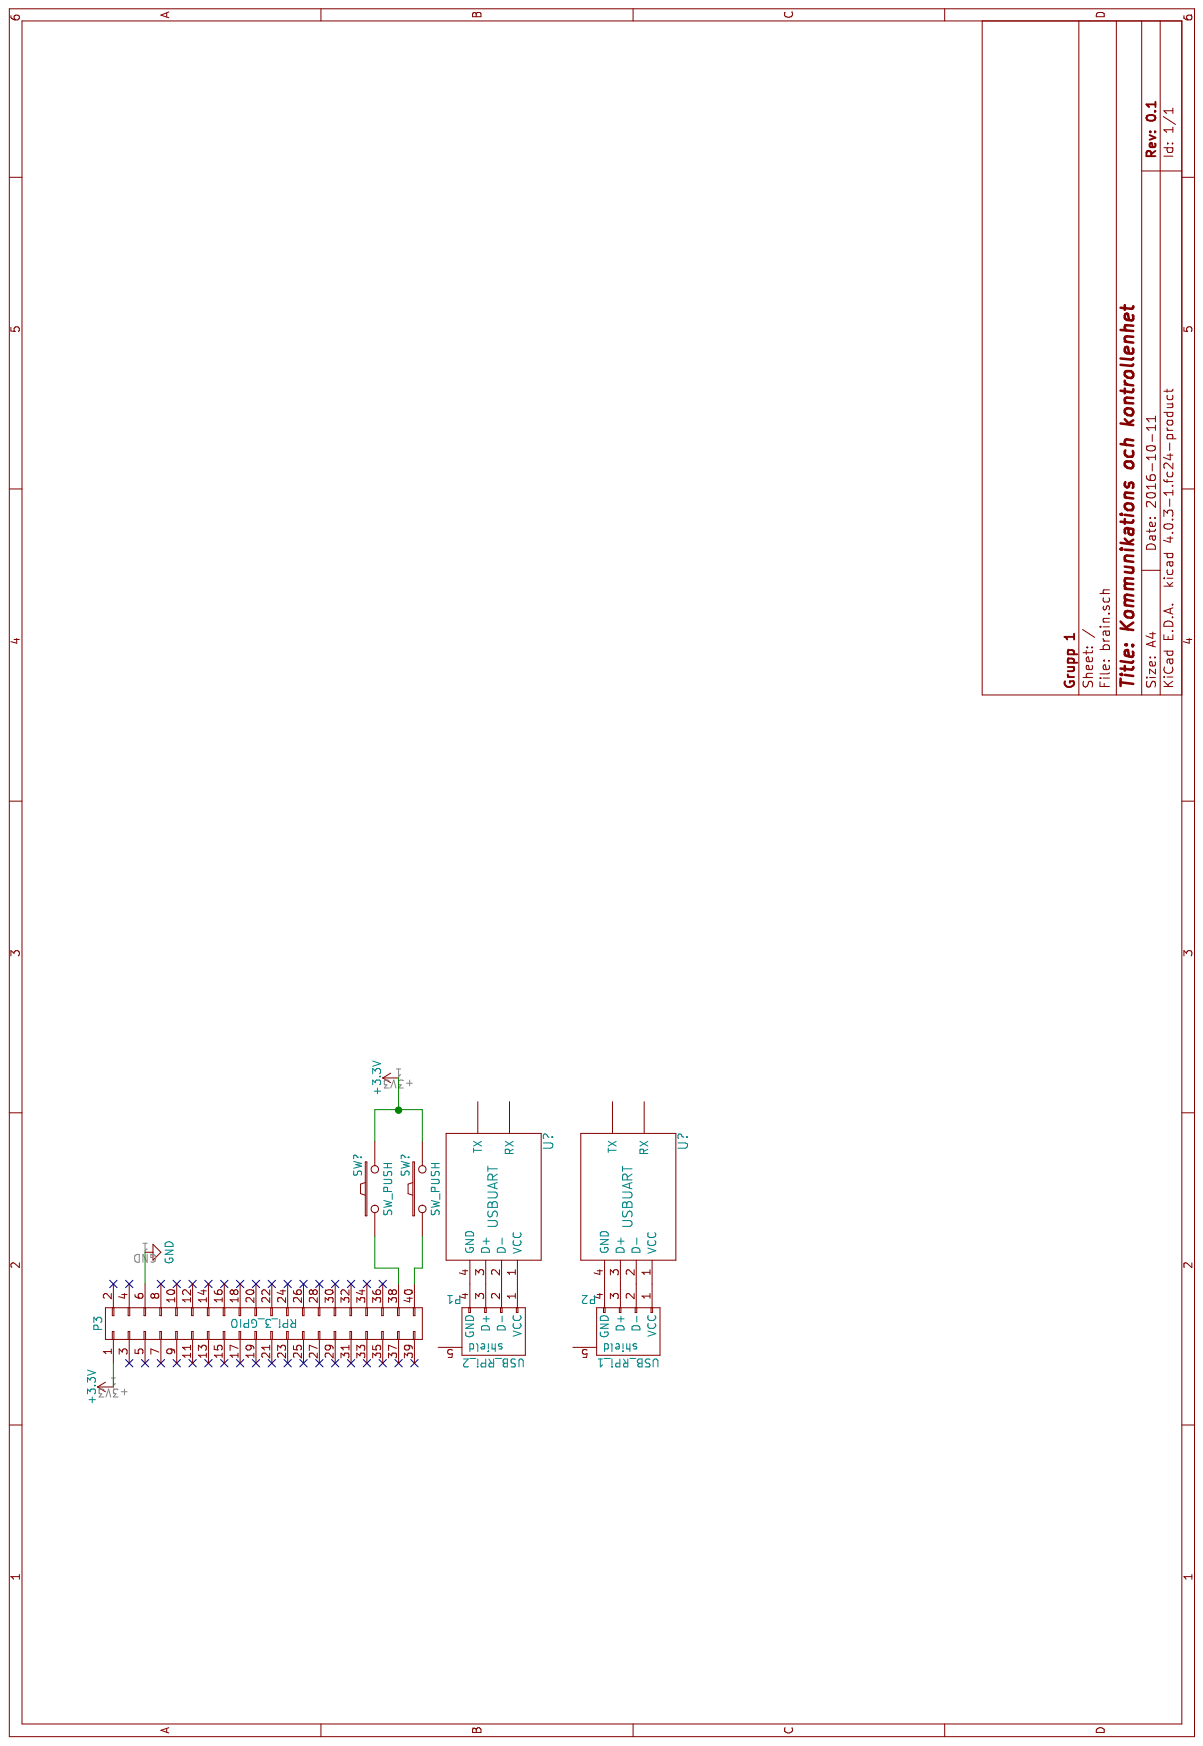
[picture p36: page 1]
