felixharnstrom/KMM_2016_Kartrobot/doc/tek_dok/schematics/brain/brain.kicad_pcb

## KiCad design KiCad/DOUBLE INA3221BMSTESTER.sch


Parts:
BT1, BT2, BT3, BT4: Battery_Cell
J1: Screw_Terminal_01x02
U1: OLED096
U4: ESP32-WROOM-32U
ina3221_1, ina3221_2: INA3221; Texas_RGV_S-PVQFN-N16_EP2.1x2.1mm

Connections:
+5V: U1.~, U4.2 (VDD), ina3221_1.4 (VS), ina3221_2.4 (VS)
BMS4S: BT1.2 (-), J1.2, U1.~, U4.1 (GND), U4.15 (GND), U4.38 (GND), U4.39 (GND), ina3221_1.1 (IN-3), ina3221_1.3 (GND), ina3221_1.5 (A0), ina3221_1.11 (IN-1), ina3221_1.14 (IN-2), ina3221_2.3 (GND), ina3221_2.11 (IN-1)
unnamed: BT1.1 (+), BT2.2 (-), ina3221_1.12 (IN+1)
unnamed: BT2.1 (+), BT3.2 (-), ina3221_1.15 (IN+2)
unnamed: BT3.1 (+), BT4.2 (-), ina3221_1.2 (IN+3)
unnamed: BT4.1 (+), J1.1, ina3221_2.12 (IN+1)
unnamed: U1.~, U4.21 (SDO/SD0), U4.22 (SDI/SD1), ina3221_1.6 (SCL), ina3221_1.7 (SDA), ina3221_2.5 (A0), ina3221_2.6 (SCL), ina3221_2.7 (SDA)
