felixharnstrom/KMM_2016_Kartrobot/dev/kontrollenhet/follow_wall.py

"""
This program endlessly follows the wall on the robot's right side. The USB devices for the control and sensor units are supplied as command-line arguments.

Examples:
        $ python3 follow_wall.py -s 'ttyUSB0' -c 'ttyUSB1'

        $ python3 follow_wall.py -sensor 'ttyUSB0' -control 'ttyUSB1' -v 3
"""
import time
import math
from map import *
import numpy as np
import logging
import argparse
from command import Command
from pid import Pid
from robot_communication import handle_command, init_UARTs
from geometry import Position
import robot_map_data

class Direction:
	"""
	Enum class defining left and right.
	"""
    LEFT = 0
    RIGHT = 1

class DriveStatus:
	"""
	Enum class containing different states that can set during the robot is driving.
	"""
    OBSTACLE_DETECTED = 0
    CORRIDOR_DETECTED_RIGHT = 1
    CORRIDOR_DETECTED_LEFT = 2
    DRIVING = 3
    WAITING = 4
    DONE = 5


class Goal:
	"""
	The autonomous states for the robot.
	"""
    MAP_OUTER_WALLS = 0
    FIND_ISLAND = 1
    DRIVE_TO_ISLAND = 2
    MAP_ISLAND = 3
    RETURN_HOME = 4
    NONE = 5


class Robot:
    """
    Contains the robot's current state and several functions enabling the robot's high-level behaviour.

    Args:
		logger						(logging): Object for enable a good logging tool. 

    Attributes:
        goal                        (Goal): What we're currently trying to do
        grid_map                    (GridMap): Mapping of room.
        start_cell_at_island        (Position): Start cell at island.
		reflex_right_start			(int): Private variable to help the robot calculate the driven distance
		reflex_right_start_2		(int): Poorly named variable also for helping the robot calculating the driven distance.
		cells						(list): List with positions for helping the robot to calculate grid_map.
        driven_distance             (int): Driven distance thus far.
        current_angle               (int): Current angle against right wall.
        path_trace                  (list): List of (angle, dist). Contains the driven path.
        pid_controller              (Pid): The PID controller in use.
        has_been_to_other_cell      (bool): Robot has left the starting position at the island.
		
        START_X                     (int): Starting x-value, in mm
        BLOCK_SIZE                  (int): Block size in millimetres.
        IR_MEDIAN_ITERATIONS        (int): Number of values to get from IR sensors.
        GYRO_MEDIAN_ITERATIONS      (int): Number of values to get from gyro.
        TURN_OVERRIDE_DIST          (int): If the right-hand sensor reaches or exceeds this value it will immediately trigger a right turn.
        TURN_MIN_DIST               (int): The minimum detected distance that will trigger a right turn.
        CORRIDOR_TURN_ENTRY_DIST    (int): How far to drive into a corner before performing a 90° turn.
        CORRIDOR_TURN_EXIT_DIST     (int): How far to drive into a corridor after performing a 90° turn.
        OBSTACLE_SAFETY_OVERRIDE    (int): The override distance that will trigger an immediate stop in drive_distance().
        EDGE_SPIKE_FACTOR           (int): How much bigger a spike in IR value must be compared to prior reading until it will trigger an edge detection.
        OBSTACLE_DIST               (int): The maximum distance until an obstacle ahead will trigger a turn.
        SENSOR_SPACING              (int): Distance between side sensors on the robot.
        BASE_SPEED                  (int): The speed that seems to work best for the controller with fully charged batteries.
        ACCELERATED_SPEED           (int): Can be used when the controller is disengaged, otherwise too fast for the controller to handle.
        WHEEL_RADIUS                (int): Radius for a wheel on the robot in cm.
        DRIVE_TO_ISLAND_THRESHOLD   (int): The robot won't drive to the island if it is further than this distance
    """

    def __init__(self, logger):
        # Public attributes
        self.grid_map = GridMap()
        self.goal = Goal.MAP_OUTER_WALLS
        self.start_cell_at_island = Position(0, 0)
        self.driven_distance = 0
        self.current_angle = 0
        self.path_trace = []  # (Angle, LengthDriven), with this list we can calculate our position
        self.logger = logger
        self.has_been_to_other_cell = False
        self.START_X = 200
        self.BLOCK_SIZE = 400
        self.IR_MEDIAN_ITERATIONS = 1
        self.GYRO_MEDIAN_ITERATIONS = 10
        self.TURN_OVERRIDE_DIST = 220
        self.TURN_MIN_DIST = 100
        self.CORRIDOR_TURN_ENTRY_DIST = 150
        self.CORRIDOR_TURN_EXIT_DIST = 250
        self.OBSTACLE_SAFETY_OVERRIDE = 80
        self.EDGE_SPIKE_FACTOR = 2
        self.OBSTACLE_DIST = 100
        self.SENSOR_SPACING = 95
        self.BASE_SPEED = 40
        self.ACCELERATED_SPEED = 40
        self.WHEEL_RADIUS = 32.5
        self.DRIVE_TO_ISLAND_THRESHOLD = 800
        init_UARTs()

        # Private attributes
        self._cells = 0
        self._read_reflex_start_2 = 0
        self._reflex_right_start = 0

        # Initialize PID controller
        self.pid_controller = Pid()
        self.pid_controller.setpoint = 100
        self.pid_controller.output_data = 0
        self.pid_controller.set_tunings(5, 0, -10)
        self.pid_controller.set_sample_time(33)
        self.pid_controller.set_output_limits(-50, 50)
        self.pid_controller.set_mode(1)

        # Read start values for X and Y
        self._y_start = self._median_sensor(10, Command.read_right_back_ir())+100
        self._x_start = self.START_X
        
    def read_ir_side(self, side: Direction):
        """
        Returs the median of IR_MEDIAN_ITERATIONS reads of the specified ir sensor pair.

        Args:
            :side    (Direction): Which side to read.
        Returns:
            (int, int): Back and front sensor readings.
        """

        if side == Direction.RIGHT:
            ir_side_front = self._median_sensor(self.IR_MEDIAN_ITERATIONS, Command.read_right_front_ir())
            ir_side_back = self._median_sensor(self.IR_MEDIAN_ITERATIONS, Command.read_right_back_ir())
        else:
            ir_side_front = self._median_sensor(self.IR_MEDIAN_ITERATIONS, Command.read_left_front_ir())
            ir_side_back = self._median_sensor(self.IR_MEDIAN_ITERATIONS, Command.read_left_back_ir())
        return ir_side_back, ir_side_front

    def update_map_status(self):
        """
        Prepare data for transmission to GUI.
        """

        global sensor_data
        robot_map_data.set_grid_map(self.grid_map.gui_drawable())
        if self.get_driven_dist():
            sensor_data["DISTANCE"] = self.get_driven_dist()[-1][1]

    def turn(self, direction: Direction, degrees: int, speed: int, save_new_angle=False):
        """
        Turn a certain amount in the given direction at a speed up to speed+30, regulating according to degrees left to turn.

        Args:
            direction   (Direction): Direction to turn.
            degrees     (int): Degrees to turn.
            speed       (int): Speed as a percentage value between 0-100.
			save_new_angle (bool) : If true, save the turned angle. Otherwise, don't save it.
        """
        # Set the current direction to zero
        current_dir = 0

        time.sleep(0.5)
        # Set time to zero to turn untill stopped
        standstill_rate = self._median_sensor(self.GYRO_MEDIAN_ITERATIONS, Command.read_gyro()) / 100
        turn_instr = Command.turn(direction, speed, 0)
        handle_command(turn_instr)

        while (abs(current_dir) < degrees):
            # Use a reimann sum to add up all the gyro rates
            # Area = TimeDiff * turnRate
            clk = time.time()
            turn_rate = self._median_sensor(self.GYRO_MEDIAN_ITERATIONS, Command.read_gyro()) / 100 - standstill_rate
            current_dir += (time.time() - clk) * turn_rate
            turn_instr = Command.turn(direction, speed * (degrees - abs(current_dir)) / degrees + 30, 0)
            handle_command(turn_instr)
            self.logger.debug("Current dir: " + str(current_dir) + " -- Turn rate: " + str(turn_rate))

        # Turning is completed, stop the motors
        turn_instr = Command.stop_motors()
        handle_command(turn_instr)

        # Add turned degrees to current_angle if save_new_angle is true
        if save_new_angle:
            if direction == Direction.LEFT:
                self.current_angle -= degrees + 5
            else:
                self.current_angle += degrees + 5

    def get_position(self):
        """
        Calculates your x and y coordinates from path_trace.

        Returns:
            (Position): Contains the x and y position.
        """
        x = self._x_start
        y = self._y_start
        last_distance = 0

        for path in self.get_driven_dist():
            angle = path[0]
            if angle != 0:
                angle_sign = abs(angle) / angle
                abs_angle = abs(angle) % 360
            else:
                angle_sign = 1
                abs_angle = 0

            distance = path[1] - last_distance

            if abs_angle == 0:
                y += distance
            elif abs_angle == 90:
                x += distance * angle_sign
            elif abs_angle == 180:
                y -= distance
            elif abs_angle == 270:
                x -= distance * angle_sign

            last_distance = path[1]

        return Position(x, y)

    def get_angle(self):
        """
        Return the robots current angle in the intervall 0 <= angle <= 360.
        Returns:
            (int): The current angle in the given intervall above.
        """
        if (self.current_angle >= 0):
            return self.current_angle % 360
        elif (self.current_angle < 0):
            return 360 - abs(self.current_angle) % 360

    def update_map(self):
        """
        Update the gridmap with new scan data. Drive to island if found. 
        """
        lines = movement_to_lines(self.get_driven_dist(), Position(self._x_start, self._y_start))
        cells = movement_lines_to_cells(lines, 1)

        self.logger.debug("Current cell" + str(cells[-1]))
        self.logger.debug("Current path" + str(self.get_driven_dist()))
        self.logger.debug("Current path: Uncalibrated" + str(self.path_trace))

        if (self.goal == Goal.MAP_OUTER_WALLS or self.goal == Goal.MAP_ISLAND) and len(cells) > 0:
            self.grid_map = GridMap()
            self._add_garage(cells[0])
            make_open(cells, self.grid_map)
            add_walls(cells, self.grid_map)

            self.logger.info("STOP")
            self.logger.info("start: " + str(cells[0]))
            self.logger.info("end: " + str(cells[-1]))
            if cells[-1] == cells[0] and len(cells) > 5:
                # We've returned to the garage
                self.goal = Goal.FIND_ISLAND
                self.logger.warning("In garage - looking for island")

        # Print grid, including current location
        old = self.grid_map.get(cells[-1].x, cells[-1].y)
        self.grid_map.set(cells[-1].x, cells[-1].y, CellType.LOCATION)
        self.grid_map.debug_print(print_origin=True)
        self.grid_map.robot_pos = Position(cells[-1].x, cells[-1].y)
        self.grid_map.set(cells[-1].x, cells[-1].y, old)
        self.logger.info("ANGLE: " + str(self.get_angle()))
        self.logger.info("POS: " + str(self.get_position()))

        if self.goal == Goal.FIND_ISLAND and cells:
            # Check if there is a island close enough, if so, drive to it.
            is_island, distance = island_exists(cells[-1], self.get_angle() - 90, self.grid_map)
            if is_island:
                self.logger.info("ISLAND!")
            else:
                self.logger.info("No island :(")
            if is_island and distance < self.DRIVE_TO_ISLAND_THRESHOLD:
                self.logger.info("DRIVE TO ISLAND!")
                self.drive_to_island()

        if cells and cells[-1] == cells[0] and self.goal == Goal.RETURN_HOME:
            # We're done!
            self.logger.info("================")
            self.logger.info(" D O N E")
            self.logger.info("================")
            self.goal = Goal.NONE
        self.update_map_status()
        # Update motor diag
        handle_command(Command.controller_information())

    def drive_distance(self, dist: int, speed: int, direction: int = 1, save_new_distance=False):
        """
        Drives the given distance at the given speed, if possible. Uses LIDAR for determining distance.

        Args:
            dist      (int): Distance in millimetres.
            speed     (int): Speed as a percentage value between 0-100.
            direction (int): 1 equals forward, 0 back.
			save_new_distance (bool): If True, save the driven distance, otherwise don't.
        Returns:
            (bool): True if the given distance was driven, false if an obstacle stopped it.
        """
        reflex_right_start = handle_command(Command.read_reflex_right())
        reflex_right = reflex_right_start
        handle_command(Command.drive(direction, speed, 0))
        # logger.debug("LIDAR INIT: ", lidar_init)
        while(reflex_right - reflex_right_start < dist):
            reflex_right = handle_command(Command.read_reflex_right())
            lidar_cur = handle_command(Command.read_front_ir())
            if lidar_cur < self.OBSTACLE_SAFETY_OVERRIDE:
                handle_command(Command.stop_motors())
                if save_new_distance:
                    print("Saving drive_distance", (reflex_right - reflex_right_start))
                    self._save_position(reflex_right - reflex_right_start)
                return False
            # logger.debug("LIDAR CURRENT: ", lidar_cur)
        handle_command(Command.stop_motors())
        if save_new_distance:
            print("Saving drive_distance", (reflex_right - reflex_right_start))
            self._save_position(reflex_right - reflex_right_start)
        return True

    def _follow_wall_step(self, distance_to_drive: int, side="right"):
        """
        Make one follow wall iteration
        Args:
            distance_to_drive     (int): The wanted distance to drive.
            side                  (str): String saying what wall to follow.
        Returns:
            (DriveStatus): Return at what stage the follow wall is at.
        """
        reflex_right = handle_command(Command.read_reflex_right())

        ir_front = self._median_sensor(self.IR_MEDIAN_ITERATIONS, Command.read_front_ir())

        if side == "right":
            ir_side_back, ir_side_front = self.read_ir_side(Direction.RIGHT)
        else:
            ir_side_back, ir_side_front = self.read_ir_side(Direction.LEFT)

        # distance_to_drive is completed. Save and return.
        if reflex_right - self._reflex_right_start > distance_to_drive:
            # Save the given length driven
            handle_command(Command.stop_motors())
            self._save_position(reflex_right - self._reflex_right_start)
            return DriveStatus.DONE

        # Do a little maintainance every 5 cm.
        if ((reflex_right - self._reflex_right_start) / 50) > self._cells:
            # Save distance driven
            self._save_position(handle_command(Command.read_reflex_right()) - self._reflex_right_start_2)
            self._reflex_right_start += (handle_command(Command.read_reflex_right()) - self._reflex_right_start_2)
            self._reflex_right_start_2 = handle_command(Command.read_reflex_right())
            self._save_position(self._reflex_right_start_2 - self._reflex_right_start)
            before = self.goal

            self.update_map()

            self._reflex_right_start = handle_command(Command.read_reflex_right())
            if self.goal == Goal.FIND_ISLAND and before != self.goal:
                return DriveStatus.DONE
            self._cells += 1

            # If the current goal is to map the island and we have returned to the starting cell, return to the outer wall.
            if self.goal == Goal.MAP_ISLAND:
                robot_position = self.get_position()
                if (self.start_cell_at_island == approximate_to_cell(robot_position) and self.has_been_to_other_cell):
                    handle_command(Command.stop_motors())
                    # self.stand_perpendicular("right")
                    self.leave_island()
                    self.logger.info("RETURNING HOME!")
                    return DriveStatus.DONE

        # Detect corridor to the right
        if (ir_side_front >= self.TURN_OVERRIDE_DIST):
            self.logger.debug("IR - front: " + str(ir_side_front) + " IR - back: " + str(ir_side_back))
            # Save the given length driven
            self._save_position(reflex_right - self._reflex_right_start)
            if side == "right":
                return DriveStatus.CORRIDOR_DETECTED_RIGHT
            else:
                return DriveStatus.CORRIDOR_DETECTED_LEFT

        # Obstacle detected, and (probably) no turn to the right
        if(ir_front < self.OBSTACLE_DIST):
            # Save the given length driven
            handle_command(Command.stop_motors())
            self._save_position(reflex_right - self._reflex_right_start)
            return DriveStatus.OBSTACLE_DETECTED

        # We need to get the distance from the center of the robot perpendicular to the wall
        dist_side = (ir_side_front + ir_side_back) / 2
        angle_side = math.atan2(ir_side_back - ir_side_front, self.SENSOR_SPACING)
        perpendicular_dist_side = dist_side * math.cos(angle_side)
        # logger.debug("PERPENDICULAR DIST RIGHT:", perpendicular_dist_right)
        self.pid_controller.input_data = perpendicular_dist_side
        self.pid_controller.d_term = angle_side
        self.pid_controller.compute()
        self.pid_controller.output_data += 100
        # Use pid output data to set speeds. Slow down before obstacles.
        self._follow_wall_help(self.pid_controller.output_data / 100, self.BASE_SPEED * min(max(ir_front-100, 200), 200) / 200, side)

        return DriveStatus.DRIVING

    def follow_wall(self, distance: int, side="right"):
        """
        Follow the wall to the right until the robot encounters a corner or obstacle, or the given distance to drive is reached.

        Args:
            dist (int): Distance in millimetres.
			side (str): Describes what side to follow.
        Returns:
            (DriveStatus): Status when completed.
        """

        if side == "right":
            # We're scanning for island on the left - turn it left
            handle_command(Command.servo(0))
        elif side == "left":
            # We're scanning for island on the right - turn it right
            handle_command(Command.servo(180))
        else:
            # Unreachable, unless caller is a moron
            # the argument should really be an enum.
            assert (False)

        self.logger.info("Side: " + side)

        # Sleep after servo turn
        # time.sleep(0.75)

        # Read start values from sensors
        # Set cells to zero
        self._cells = 0
        self._reflex_right_start = handle_command(Command.read_reflex_right())
        self._reflex_right_start_2 = handle_command(Command.read_reflex_right())

        # Drive until the wanted distance is reached unless the automus mode is turned off
        drive_status = DriveStatus.DRIVING
        while (drive_status == DriveStatus.DRIVING):
            drive_status = self._follow_wall_step(distance, side)

        return drive_status

    def update_pid(self):
        """
        Update the PID values.
        """
        self.pid_controller.kp = 0
        self.pid_controller.ki = 0
        self.pid_controller.kd = 0
        self.pid_controller.set_tunings(5, 0, -10)

    def scan(self):
        """
        Scan the room at this position and return the recorded data.

        Returns:
            (list): Recorded data in a list of distances, where the index is the servo degree
        """
        recorded_data = []  # (Angle, distance)
        # Turn LIDAR to 0 degrees
        servo_instr = Command.servo(0)
        handle_command(servo_instr)

        # Sleep 1 second to wait for LIDAR to be in position
        time.sleep(1)

        for i in range(180):
            # Point LIDAR in the right angle
            servo_instr = Command.servo(i)
            handle_command(servo_instr)

            # Read data from the LIDAR sensor
            lidar_distance = handle_command(Command.read_lidar())
            recorded_data.append([i, lidar_distance])
            time.sleep(0.005)

        # Point LIDAR forward
        handle_command(Command.servo(180))

        return recorded_data

    def stand_perpendicular(self, side: str):
        """
        Turn to stand perpendicular to the wall at the given side.

        Args:
            side (str): 'left' or 'right'
        """
        if side == "left":
            ir_back, ir_front = self.read_ir_side(Direction.LEFT)
            angle = math.atan2(ir_back - ir_front, self.SENSOR_SPACING)
            self.turn(math.degrees(angle) > 0, abs(int(math.degrees(angle))), speed=self.BASE_SPEED+10)

        elif side == "right":
            ir_back, ir_front = self.read_ir_side(Direction.RIGHT)
            angle = math.atan2(ir_back - ir_front, self.SENSOR_SPACING)
            self.turn(math.degrees(angle) < 0, abs(int(math.degrees(angle))), speed=self.BASE_SPEED+10)

    def leave_island(self):
        """
        Turn left, drive to the wall and turn right
        """
        self.drive_distance(100, self.BASE_SPEED, 0, save_new_distance=False)
        self.turn(Direction.LEFT, 85, speed=self.ACCELERATED_SPEED, save_new_angle=True)
        self.drive_distance(99999, self.BASE_SPEED, save_new_distance=True)
        self.turn(Direction.RIGHT, 85, speed=self.ACCELERATED_SPEED, save_new_angle=True)
        self.drive_distance(100, self.BASE_SPEED, 1, save_new_distance=False)
        # self.stand_perpendicular("left")
        self.goal = Goal.RETURN_HOME

    def drive_to_island(self):
        """
        Turn towards the island, drive to it and then turn left so that
        the robot will follow the right side of the wall.
        """
        handle_command(Command.stop_motors())
        # self.stand_perpendicular("right")
        time.sleep(0.5)
        self.drive_distance(80, self.BASE_SPEED, save_new_distance=True)
        self.turn(Direction.LEFT, 85, speed=self.ACCELERATED_SPEED, save_new_angle=True)
        self.drive_distance(99999, self.BASE_SPEED, save_new_distance=True)
        self.turn(Direction.LEFT, 85, speed=self.ACCELERATED_SPEED, save_new_angle=True)
        self.start_cell_at_island = approximate_to_cell(self.get_position())
        self.goal = Goal.MAP_ISLAND

    def _add_garage(self, where: Position):
        """
        Add a garage in the desired cell.
		
		Args:
			where		(Position): Where should the garage be placed?
        """
        # Update grid_map to include garage
        self.grid_map.set(where.x - 1, where.y, CellType.WALL)
        self.grid_map.set(where.x, where.y + 1, CellType.WALL)
        self.grid_map.set(where.x, where.y - 1, CellType.WALL)
        self.grid_map.set(where.x, where.y, CellType.OPEN)

    def _median_sensor(self, it: int, sensor_instr: Command):
        """
        Return the median value of the specified number of readings from the given sensor.

        Args:
            it              (int): Number of sensor values.
            sensor_instr    (Command): A sensor command.

        Returns:
            (int): Median value.
        """
        values = []
        for i in range(it):
            values.append(handle_command(sensor_instr))
        if len(values) == 1:
            return values[0]
        else:
            return np.median(values)

    def _save_position(self, unsaved_distance:   int):
        """
        Save the collected data to the trace list.

        Args:
            unsaved_distance   (int): Reflex data that have been driven but not added to self.driven_distance
        """
        print("SAVING", unsaved_distance)
        if self.goal == Goal.MAP_ISLAND:
            self.driven_distance += unsaved_distance
        elif self.goal == Goal.RETURN_HOME:
            self.driven_distance += unsaved_distance
        else:
            self.driven_distance += unsaved_distance
        self.path_trace += [(self.current_angle, self.driven_distance)]

    def get_driven_dist(self):
        """
        Convert path_trace to distances of 400*n mm.
		
        Return:
            (list): List of (angle, distance), split at each angle change.
        """
        distances = self.path_trace
        last_angle = None
        new_list = []
        for angle, dist in distances:
            # print (angle, dist)
            if last_angle == angle:
                # print("merging")
                new_list[-1][1] = dist
            else:
                new_list.append([angle, dist])
            last_angle = angle

#        print("Merged distances", new_list)

        dist_list = [[0, 0]]

        for i in range(len(new_list)):
            angle, dist = new_list[i]
            dist_list.append([angle, dist_list[-1][1] + round(dist/400) * 400])
            # print (new_list)
            for j in range(i+1, len(new_list)):
                new_list[j][1] = new_list[j][1] - dist
            # print (new_list)

        # print (dist_list)
        dist_list = dist_list[1:]
        return dist_list

    def _follow_wall_help(self, ratio: int, base_speed: int, side="right"):
        """
        Calculate motor speeds and send drive instruction.

        Args:
            ratio       (int): Will drive forward if exactly 1, turn left if > 1, and turn right if < 1.
            base_speed  (int): Base speed that ratio will be applied to.
            side        (str): 'left' or 'right'
        """
        left_speed = max(min(base_speed / ratio, 100), 0)
        right_speed = max(min(base_speed * ratio, 100), 0)
        if side == "right":
            drive_instr = Command.side_speeds(1, round(left_speed), 1, round(right_speed))
        else:
            drive_instr = Command.side_speeds(1, round(right_speed), 1, round(left_speed))
        handle_command(drive_instr)

    def _is_moving(self, threshold=30, wait_time=0.2):
        """
        Note: Currently ignored. Can be used by uncommenting sleep and outcommenting the first return.
        Checks for sensor changes above threshold within wait_time.
        Args:
            threshold   (int): How much the sensor values are allowed to change (mm)
            wait_time   (int): How long to wait between sensor reads
        Returns:
            (bool): If the robot has moved more than threshold.
        """
        ir_back = self._median_sensor(self.IR_MEDIAN_ITERATIONS, Command.read_front_ir())
        lidar = self._median_sensor(self.IR_MEDIAN_ITERATIONS, Command.read_lidar())
        ir_right_back, ir_right_front = self.read_ir_side(Direction.RIGHT)
        ir_left_back, ir_left_front = self.read_ir_side(Direction.LEFT)

        # time.sleep(wait_time)
        return False
        ir_back_diff = abs(ir_back - self._median_sensor(self.IR_MEDIAN_ITERATIONS, Command.read_front_ir()))
        lidar_diff = abs(lidar - self._median_sensor(self.IR_MEDIAN_ITERATIONS, Command.read_lidar()))
        ir_right_front_diff = abs(ir_right_front - self._median_sensor(self.IR_MEDIAN_ITERATIONS, Command.read_right_front_ir()))
        ir_right_back_diff = abs(ir_right_back - self._median_sensor(self.IR_MEDIAN_ITERATIONS, Command.read_right_back_ir()))
        ir_left_back_diff = abs(ir_left_back - self._median_sensor(self.IR_MEDIAN_ITERATIONS, Command.read_left_back_ir()))
        ir_left_front_diff = abs(ir_left_front - self._median_sensor(self.IR_MEDIAN_ITERATIONS, Command.read_left_front_ir()))

        if (lidar_diff < threshold and ir_right_back_diff < threshold and
            ir_right_front_diff < threshold and ir_back_diff < threshold and
            ir_left_back_diff < threshold and ir_left_front_diff < threshold):
            return False
        else:
            # logger.debug("MOVING: threshold=", threshold, "mm, wait_time", wait_time)
            return True


def sensor_test(robot):
    """
    Continuously get all sensor values and print these.
    """
    while 1:
        ir_right_back, ir_right_front = robot.read_ir_side(Direction.RIGHT)
        ir_left_back, ir_left_front = robot.read_ir_side(Direction.LEFT)
        ir_back = robot._median_sensor(robot.IR_MEDIAN_ITERATIONS, Command.read_front_ir())
        lidar = robot._median_sensor(1, Command.read_lidar())
        robot.logger.debug("IR_RIGHT_BACK: " + str(ir_right_back) + " IR_RIGHT_FRONT : " + str(ir_right_front) + " LIDAR: " + str(lidar), "IR_LEFT_BACK", ir_left_back, "IR_LEFT_FRONT", ir_left_front, "IR_BACK", ir_back)
