felixharnstrom/KMM_2016_Kartrobot/dev/kontrollenhet/mode.py

"""
This file contains the functions necessary for setting/detecting which mode that the robot currently is in.
"""
import threading
from enum import Enum

class ControlModeEnums(Enum):
    """
    Contains the enums for the different modes that we can be in.
    """
    AUTONOMOUS = 0
    MANUAL = 1

"""The current mode which we are in."""
_mode = ControlModeEnums.AUTONOMOUS
"""Lock used for reading/editing our current mode"""
_mode_lock = threading.Lock()

def set_mode(new_mode : ControlModeEnums):
    """
    Sets the current mode to the given mode.
    
    Args:
        :param new_mode (ControlModeEnums): The new mode to set
    """
    global _mode
    print("Mode changed")
    _mode_lock.acquire()
    _mode = new_mode
    _mode_lock.release()

def get_mode():
    """
    Returns the current mode.
    
    Returns:
        :return (ControlModeEnums): The mode which we are currently in.
    """
    _mode_lock.acquire()
    mode_enum = _mode
    _mode_lock.release()
    return mode_enum

def toggle_mode():
    """
    Toggles the current mode between AUTONOMOUS and MANUAL.
    """
    global _mode
    print("Mode changed toggled.")
    _mode_lock.acquire()
    if(_mode == ControlModeEnums.AUTONOMOUS):
        _mode = ControlModeEnums.MANUAL
    else:
        _mode = ControlModeEnums.AUTONOMOUS
    _mode_lock.release()
