felixharnstrom/KMM_2016_Kartrobot/dev/PC/gui.py

import threading
import mtTkinter as tkinter
import os


class gui_thread(threading.Thread):
    """
    Initiates the GUI on a seperate thread. Contains all variables and methods to used to display the different kinds of data from the robot, 
    aswell as the methods necessary to generate actions for the WiFi-thread to transmit.
    
    Args:
        :param queue_output                (Queue): Used to transmit actions FROM the GUI to the  WiFi-thread, for example keyevents.
    
    Attributes:
        :attribute cell_width               (int): Defines the width and height of a cell (pixels) in the map grid.
        :attribute robot_width              (int): Defines the width and height of the robot (pixels) in the map grid.
        :attribute grid_size                (int): Defines the number of cells which appear per column and per row in the map. The number of actual cells will always be this number squared.
        :attribute grid                     (list of lists with rectangles): Contains the tkinter rectangles generated for each map cell. 
                                             The list contains lists with each row of rectangle cells in the map grid, seen from the top left corner to the bottom right.  
        :attribute robot_rect               (rectangle): The tkinter rectangle that represents the robot.
        :attribute queue                    (Queue): The Queue that is used for transmitting GUI events to the WiFi-thread.
        :attribute pressed_keys             (dict): Contains the pressed state of the arrows keys. True equals pressed, false means that it is not.
        :attribute gui                      (Tk): The GUI object.
        :attribute canvas                   (canvas): The canvas which is used for drawing the map.
        :attribute left_motor_speed         (DoubleVar): The left motor speed value.
        :attribute right_motor_speed        (DoubleVar): The right motor speed value.
        :attribute servo_angle              (DoubleVar): The servo angle value.
        
        :attribute lidar                    (DoubleVar): The LIDAR distance value.
        :attribute ir_front_left            (DoubleVar): The IR-front-left value. (As placed on chassi, not driving direction)
        :attribute ir_front_right           (DoubleVar): The IR-front-right value. (As placed on chassi, not driving direction)
        :attribute ir_back_left             (DoubleVar): The IR-back-left value. (As placed on chassi, not driving direction)
        :attribute ir_back_right            (DoubleVar): The IR-back-right value. (As placed on chassi, not driving direction)
        :attribute ir_behind                (DoubleVar): The IR-behind value. (As placed on chassi, not driving direction)
        :attribute reflex_left              (DoubleVar): The left reflex sensor value. (As placed on chassi, not driving direction)
        :attribute reflex_right             (DoubleVar): The right reflex sensor value. (As placed on chassi, not driving direction)
        :attribute distance                 (DoubleVar): The distance the robot has traveled in autonomous mode since last mode change.
        :attribute mode_var                 (Intvar): The current mode that the robot is in. 0 = Autonomous, 1 = Manual.
    """

    def __init__(self, queue_output):
        # Make pythons thread library happy
        threading.Thread.__init__(self)

        # Make variables accessible to the whole class
        self.cell_width = 10
        self.robot_width =self.cell_width - 2
        self.grid_size = 24 # The number of cells that can appear in each row and column of the map, 24 to be safe (24^2 cells)
        self.grid = []
        self.robot_rect = None
        self.queue = queue_output
        self.pressed_keys = {"left":False, "right":False, "up":False, "down":False}
        
        #GUI-components
        self.gui = None
        self.canvas = None
        
        #GUI-value variables
        #Motor diag
        self.left_motor_speed = None
        self.right_motor_speed = None
        self.servo_angle = None
        
        #Sensor diag
        self.lidar = None
        self.ir_front_left = None
        self.ir_front_right = None
        self.ir_back_left = None
        self.ir_back_right = None
        self.ir_behind = None
        self.reflex_left = None
        self.reflex_right = None
        self.distance = None
        self.mode_var = None
 
    def key_pressed(self, event):
        """
        Callback handler for keys that are pressed.
        
        Args:
            :param event (event): The callback event.
        
        """
        button = event.keysym
        if button == "Left" and not self.pressed_keys["left"]:
            self.pressed_keys["left"] = True
            self.send_command("key_left_p")
        elif button == "Right" and not self.pressed_keys["right"]:
            self.pressed_keys["right"] = True
            self.send_command("key_right_p")
        elif button == "Up" and not self.pressed_keys["up"]:
            self.pressed_keys["up"] = True
            self.send_command("key_up_p")
        elif button == "Down" and not self.pressed_keys["down"]:
            self.pressed_keys["down"] = True
            self.send_command("key_down_p")


    def key_released(self, event):
        """
        Callback handler for keys that are released.
        
        Args:
            :param event (event): The callback event.
        
        """
        button = event.keysym
        if button == "Left":
            self.pressed_keys["left"] = False
            self.send_command("key_left_r")
        elif button == "Right":
            self.pressed_keys["right"] = False
            self.send_command("key_right_r")
        elif button == "Up":
            self.pressed_keys["up"] = False
            self.send_command("key_up_r")
        elif button == "Down":
            self.pressed_keys["down"] = False
            self.send_command("key_down_r")

    def send_command(self, command):
        """
        Puts a command into the output_queue, meaning that it will be handled by the WiFi-thread.
        
        Args:
            :param cmd (str): The command to send.
        """
        self.queue.put(command)

    def receive_command(self, command):
        """
        Receives a command and handles it by updating the GUI, in a way that varies depending on which command-type that was received.
        
        Args:
            :param command (list): A list which always contains a command-type specifier given as a string as the first element (command[0]).
                                   The other parameters will vary depending on which command-type that was received.
        """
        if type(command)==list:
            if command[0] == "draw":
                # It was a draw command.
                # Instruct the gui to place a marker on its canvas at the point specified in "command"
                self.place_marker_on_canvas(command[1], command[2])
            elif command[0] == "set_motors":
                self.left_motor_speed.set(command[1])
                self.right_motor_speed.set(command[2])
            elif command[0] == "set_servo":
                self.servo_angle.set(command[1])
            elif command[0] == "set_sensors":
                sensor_data_dict = command[1]
                self.ir_front_left.set(sensor_data_dict["IR_LEFT_FRONT"])
                self.ir_front_right.set(sensor_data_dict["IR_RIGHT_FRONT"])
                self.ir_back_left.set(sensor_data_dict["IR_LEFT_BACK"])
                self.ir_back_right.set(sensor_data_dict["IR_RIGHT_BACK"])
                self.ir_behind.set(sensor_data_dict["IR_BACK"])
                self.lidar.set(sensor_data_dict["LIDAR"])
                self.gyro.set(sensor_data_dict["GYRO"])
                self.reflex_right.set(sensor_data_dict["REFLEX_RIGHT"])
                self.reflex_left.set(sensor_data_dict["REFLEX_LEFT"])
                self.distance.set(sensor_data_dict["DISTANCE"])
            elif command[0] == "update_mode":
                #0 = autonomous, 1 = manual
                mode_integer = command[1]
                self.mode_var.set(mode_integer)
            elif command[0] == "update_map":
                robot_xy = command[1] # [x,y]
                map_data = command[2] # [row1,row2,...,rowN] where a row is [cell1,cell2,...,cellN] for each row.
                self.draw_map(map_data)
                print("Robot X:", robot_xy[0],", Y:",robot_xy[1])
                self.draw_robot_position(robot_xy[0], robot_xy[1])
        return

    def place_marker_on_canvas(self, canv : tkinter.Canvas, x : int, y : int, size :int, color_string : str):
        """
        Places a square marker on the given canvas using a center point, width and color to be used.
        
        Args:
            :param canv         (Canvas): The tkinter Canvas on which to draw the rectangle.
            :param x            (int): The x-coordinate to use as center.
            :param y            (int): The y-coordiante to use as center.
            :param size         (int): Half the width of square marker which to draw.
            :param color_string (str): The color to be used for the marker.
            
        Returns:
            :return (int): The internal Canvas ID for the drawn square marker. This can be used to manipulate it inside the Canvas object.
        """
        return canv.create_rectangle(x - size, y - size,
                                     x + size, y + size,
                                     fill=color_string)

    def init_canvas(self, canv : tkinter.Canvas):
        """
        Initiates the map grid by creating a square grid containing grid_size^2 white square markers, according to the attributes in the class.
        These will not overlap, given that the canvas size is enough.
        
        Args:
            :param canv (Canvas): The Canvas object on which to initiate and draw the grid on.
        """
        for y in range(0,self.grid_size):
            self.grid.append([])
            for x in range(0,self.grid_size):
                self.grid[y].append(self.place_marker_on_canvas(canv, self.cell_width+2*self.cell_width*x,self.cell_width+2*self.cell_width*y, self.cell_width, "white"))




    def run(self):
        """
        Starts and setups the GUI with all components and event binds. 
        Then puts it into its mainloop.
        """

        # The usual gui setup.
        self.gui = tkinter.Tk()
        self.gui.minsize(800, 400)
        self.gui.grid()

        # Bind keys
        self.gui.bind("<Left>", self.key_pressed)
        self.gui.bind("<Right>", self.key_pressed)
        self.gui.bind("<Up>", self.key_pressed)
        self.gui.bind("<Down>", self.key_pressed)
        self.gui.bind("<KeyRelease-Left>", self.key_released)
        self.gui.bind("<KeyRelease-Right>", self.key_released)
        self.gui.bind("<KeyRelease-Up>", self.key_released)
        self.gui.bind("<KeyRelease-Down>", self.key_released)

        # We need to know how big our window got.
        self.gui.update()
        window_width = self.gui.winfo_width()
        window_height = self.gui.winfo_height()

        # Split the window into frames
        canvas_frame = tkinter.Frame(self.gui, width=window_width/2, height=window_height)
        canvas_frame.grid(row=0, column=0, rowspan=2)

        sensor_frame = tkinter.Frame(self.gui, width=window_width/4, height=window_height)
        sensor_frame.grid(row=0, column=2, rowspan=2,sticky = tkinter.N)
        self.gui.grid_columnconfigure(2, weight=1)

        button_frame = tkinter.Frame(self.gui, width=window_width/4, height=window_height/2)
        button_frame.grid(row=0, column=1)

        debug_frame = tkinter.Frame(self.gui, width=window_width/4, height=window_height/2)
        debug_frame.grid(row=1, column=1)

        # Place a canvas into canvas_frame
        self.canvas = tkinter.Canvas(canvas_frame, width=window_width/2, height=window_height)
        self.canvas.place(height=window_height, width=window_width/2)

        # Create a bunch of buttons in the left frame.
        # Each button will place a command in the queue using send_command

        # Mode switching buttons
        self.mode_var = tkinter.IntVar()
        R1 = tkinter.Radiobutton(button_frame, text="Manual", variable=self.mode_var, value=1,
                         command=lambda message="mode_manual": self.send_command(message))
        R1.pack()

        R2 = tkinter.Radiobutton(button_frame, text="Autonomous", variable=self.mode_var, value=0,
                         command=lambda message="mode_autonomous": self.send_command(message))
        R2.pack()

        self.mode_var.set(1)
   
        self.left_motor_speed = tkinter.DoubleVar()
        motor_left_scale = tkinter.Scale(debug_frame, variable=self.left_motor_speed, orient=tkinter.HORIZONTAL,
                                              from_=-100, to=100, state=tkinter.DISABLED)
        motor_left_scale.pack()
        self.insert_text(" Left Motor Speed ", debug_frame)

        self.right_motor_speed = tkinter.DoubleVar()
        motor_right_scale = tkinter.Scale(debug_frame, variable=self.right_motor_speed, orient=tkinter.HORIZONTAL,
                                               from_=-100, to=100, state=tkinter.DISABLED)
        motor_right_scale.pack()
        self.insert_text(" Right Motor Speed ", debug_frame)
        
        self.servo_angle = tkinter.DoubleVar()
        servo_angle_scale = tkinter.Scale(debug_frame, variable=self.servo_angle, orient=tkinter.HORIZONTAL,
                                                 to=180, state=tkinter.DISABLED)
        servo_angle_scale.pack()
        self.insert_text(" Servo Angle ", debug_frame)

        # Quit button
        quit_button = tkinter.Button(button_frame, text='QUIT',
                                     command=lambda message="quit": self.send_command(message))
        quit_button.pack()

        #Insert manual instructions
        self.insert_text("Use the arrow keys to\nmove in manual mode.", button_frame)

        #Setup sensor frame
        sensor_frame.grid_columnconfigure(1, weight=1)

        reflex_text = tkinter.Label(sensor_frame,text="[Reflex Sensors]")
        reflex_text.grid(row=0, column=0, columnspan=2, pady = 10)
        self.reflex_left = tkinter.DoubleVar()
        reflex_left_lab = tkinter.Label(sensor_frame, textvariable=self.reflex_left)
        reflex_left_lab.grid(row=1, column=0, padx = 18)
        self.reflex_right = tkinter.DoubleVar()
        reflex_right_lab = tkinter.Label(sensor_frame,textvariable=self.reflex_right)
        reflex_right_lab.grid(row=1, column=1, padx= 18)
        
        ir_front_text = tkinter.Label(sensor_frame,text="[IR sensors front]")
        ir_front_text.grid(row=2, column=0, columnspan=2, pady = 10)
        self.ir_front_left = tkinter.DoubleVar()
        ir_front_left_lab = tkinter.Label(sensor_frame, textvariable=self.ir_front_left)
        ir_front_left_lab.grid(row=3, column=0, padx = 18)
        self.ir_front_right = tkinter.DoubleVar()
        ir_front_right_lab = tkinter.Label(sensor_frame,textvariable=self.ir_front_right)
        ir_front_right_lab.grid(row=3, column=1, padx= 18)

        ir_back_text = tkinter.Label(sensor_frame,text="[IR sensors back]")
        ir_back_text.grid(row=4, column=0, columnspan=2, pady = 10)
        self.ir_back_left = tkinter.DoubleVar()
        ir_back_left_lab = tkinter.Label(sensor_frame, textvariable=self.ir_back_left)
        ir_back_left_lab.grid(row=5, column=0, padx = 18)
        self.ir_back_right = tkinter.DoubleVar()
        ir_back_right_lab = tkinter.Label(sensor_frame,textvariable=self.ir_back_right)
        ir_back_right_lab.grid(row=5, column=1, padx= 18)

        ir_behind_text = tkinter.Label(sensor_frame,text="[IR backside]")
        ir_behind_text.grid(row=6, column=0, columnspan=2, pady = 10)
        self.ir_behind = tkinter.DoubleVar()
        ir_behind_lab = tkinter.Label(sensor_frame, textvariable=self.ir_behind)
        ir_behind_lab.grid(row=7, column=0, columnspan=2, padx = 18)

        lidar_text = tkinter.Label(sensor_frame,text="[LIDAR]")
        lidar_text.grid(row=8, column=0, columnspan=2, pady = 10)
        self.lidar = tkinter.DoubleVar()
        lidar_lab = tkinter.Label(sensor_frame, textvariable=self.lidar)
        lidar_lab.grid(row=9, column=0, columnspan=2, padx = 18)

        gyro_text = tkinter.Label(sensor_frame,text="[GYRO]")
        gyro_text.grid(row=10, column=0, columnspan=2, pady = 10)
        self.gyro = tkinter.DoubleVar()
        gyro_lab = tkinter.Label(sensor_frame, textvariable=self.gyro)
        gyro_lab.grid(row=11, column=0, columnspan=2, padx = 18)
        
        distance_text = tkinter.Label(sensor_frame,text="[Distance Traveled]")
        distance_text.grid(row=12, column=0, columnspan=2, pady = 10)
        self.distance = tkinter.DoubleVar()
        distance_lab = tkinter.Label(sensor_frame, textvariable=self.distance)
        distance_lab.grid(row=13, column=0, columnspan=2, padx = 18)
        
        #Setup canvas
        self.init_canvas(self.canvas)
        #Setup exit routine
        self.gui.protocol("WM_DELETE_WINDOW", lambda message="quit": self.send_command(message))

        # Start tkinters mainloop
        self.gui.mainloop()

    def insert_text(self, txt, target):
        """
        Inserts and packs text on a target frame. Supports multiline with \n in txt.
        
        Args:
            :param txt      (str): The text to put on the target frame.
            :param target   (frame): The frame to put the text on.
        """
        lines = txt.split("\n")
        longest_line_len = max(len(line) for line in lines)
        text = tkinter.Text(target, height=len(lines), width=longest_line_len)
        for line in lines:
            text.insert(tkinter.INSERT, line)
        text.config(state=tkinter.DISABLED, pady=5)
        text.pack()

    def draw_map(self, map_data : list):
        """
        Updates the canvas map with the input map data. All old changes will be overwritten.
        
        Args:
            :param map_data (2D-list of ints): The 2D-list containing lists of row-cells. Following the format:
             [row1,row2,...,rowN] where a row is [cell1,cell2,...,cellN] for each row.
        """
        scanned_rows = 0
        scanned_cols = 0
        for y,mapy in enumerate(map_data): #y gives the multiplier for each row
            if scanned_rows < y:
                scanned_rows = y
            for x,mapx in enumerate(mapy): #x gives the multiplier for each col
                if scanned_cols < x:
                    scanned_cols = x           
                if mapx==1:
                    self.canvas.itemconfig(self.grid[y][x], fill="black")
                else:
                    self.canvas.itemconfig(self.grid[y][x], fill="grey")
                    
    def draw_robot_position(self, x : int, y : int):
        """
        Redraws the robot on the map canvas with the new position.
        
        Args:
            :param x (int): The new x-cell coordinate.
            :param y (int): The new y-cell coordinate.
        """
        if self.robot_rect != None:
            self.canvas.delete(self.robot_rect)
            self.robot_rect = None
        self.robot_rect =  self.place_marker_on_canvas(self.canvas, self.cell_width+2*self.cell_width*x,
                                                        self.cell_width+2*self.cell_width*y, self.robot_width, "green")
