felixharnstrom/KMM_2016_Kartrobot/(commit log)

2016-09-06 Remove redundant point about control-unit-transmission of motor control data
2016-09-07 Fix intro description for the sensor module
2016-09-07 Reformulate calibration sensor and emergency brake requirement
2016-09-07 Move gyro to prio 2 and six->multiple distance sensors
2016-09-07 Math-formatted variables motor instructions
2016-09-07 Control>send signals for motor communicatnion
2016-09-07 Add arrows to sensors
2016-09-07 Add input switches to drawings
2016-09-08 Remove Raspberry 3-requirement. Add /me to document history
2016-09-16 LIDAR text
2016-09-16 Write about sensor unit
2016-09-16 Superscriptify I2C
2016-09-16 IMU description
2016-09-16 Ultrasonic ranger description
2016-09-18 Servo motors hardware
2016-09-18 Add motor signal description
2016-09-18 UART clarifications
2016-09-19 Wire to interrupt ports, not daisy chain
2016-09-19 Servo alternative and TODOs added
2016-09-20 I2C downgraded to second alternative
2016-09-21 Add lidar to sensor unit processor interrupt reasoning
2016-09-21 Sensor module has both input and output
2016-09-22 Merged updated time sheet from tidsplan branch
    [tidsplanering.xls]
2016-09-24 Revised after comments on v0.1
    [tidsplanering.xls]
2016-09-24 Fixed customer name
    [tidsplanering.xls]
2016-09-24 Fixed tidsplanering and activities in projektplan...
    [tidsplanering.xls]
2016-09-24 Upgraded to v1.0
    [tidsplanering.xls]
2016-10-03 Updated time plan
    [tidsplanering_current.xls, tidsplanering_original.xls]
2016-10-06 Added sensorenhet.tex file
2016-10-06 Deleted the sensorenheten text from designspec.tex, taht text is added to sensorenhet.tex
2016-10-06 Added list of hardware for the sensors
2016-10-07 Add kicad schematics for styrenhet
    [styrenhet.kicad_pcb, styrenhet.sch]
2016-10-09 Move schematics to seperate branch
    [styrenhet.kicad_pcb, styrenhet.sch]
2016-10-09 Add initial sensorenhet schematics
    [sensorenhet.kicad_pcb, sensorenhet.sch]
2016-10-09 Add IR sensors
    [sensorenhet.sch]
2016-10-09 Remove front IR sensor
    [sensorenhet.sch]
2016-10-10 Added smal changes for IR-sensor
2016-10-10 Updated styrenheten, beginned with the dia for flowchart.
2016-10-10 Flowchart added.
2016-10-10 flowchart implemented controlling for AX-12 engine.
2016-10-10 Flowchart and text updated.
2016-10-10 Removed wrong arrow from flowchart.
2016-10-11 Text change from Ultraljudssensor to IR-sensor
2016-10-11 Wrote more to IR-sensor and started writing about IMU
2016-10-11 Smal adjustments in IR-sensorer
2016-10-11 Name kicad project
2016-10-11 Add brain schematics
    [brain.kicad_pcb, brain.sch]
2016-10-11 Add component lib
    [brain.sch]
2016-10-11 Fix error for rpi_gpio in lib
    [brain.sch]
2016-10-11 Add two more IR sensors
    [sensorenhet.sch]
2016-10-11 Add gyro
    [sensorenhet.sch]
2016-10-12 Added PC software flowchart
2016-10-12 Added missing lablel to flowchart
2016-10-12 Added missing reference to flowchart
2016-10-12 Add todo for servo
    [styrenhet.sch]
2016-10-12 Fix rpi pins
    [brain.sch]
2016-10-12 Fix RPI in lib (dont use spaces in component names)
    [brain.sch]
2016-10-12 Updated introduction to use IR sensors
2016-10-12 Interrupt are no longer a reason for Atmega1284
2016-10-12 Remove I2C interface
2016-10-13 Add servo to styrenhet
    [styrenhet.sch]
2016-10-13 Gyro choise, Ultrasonic>IR with LP-filter and number of sensors fixed in drawing
2016-10-14 Proofread and fix IR-sensor section.
2016-10-14 Use simple switch instead of button
    [brain.sch]
2016-10-14 Add reset to styrenhet
    [styrenhet.sch]
2016-10-14 Replace CH340G with general USB-UART
    [brain.sch]
2016-10-15 Replaced AX-12 with generic servo
2016-10-15 Fix unconnected servo
    [styrenhet.sch]
2016-10-16 Updated flowchart to conform to standard document style
2016-10-16 Add JTAG programmer
    [sensorenhet.sch, styrenhet.sch]
2016-10-16 Add gyro section
2016-10-16 Add LP-Filter to IR sensors
    [sensorenhet.sch]
2016-10-16 Moved PC software flowchart from appendices to PC section
2016-10-16 Added more information to software chapter introduction in sensorenhet
2016-10-17 Remov old comparision between UART and I2C
2016-10-17 LIDAR uses two pins on the atmega side. Remove leftovers from I2C comparison
2016-10-17 Remove (duplicted) lidar info not related to interfaces
2016-10-17 Move gyro text from interface to hardware. Add section about temperature sensor
2016-10-17 LP-filter section clarified. Minor language changes
2016-10-17 Add button to brain schematics
    [brain.sch]
2016-10-17 Use button for reset
    [styrenhet.sch]
2016-10-17 Use two buttons with brain. Switch does not belong here.
    [brain.sch]
2016-10-17 Mention of UART between sensor and control unit.
2016-10-20 Assuming servo runs on 5v (drawing)
2016-10-20 Servo uses PWM (drawing)
2016-10-20 Add schematics as appendices
2016-10-20 Move USB-Uart to brain section
2016-10-20 Remove old notes about i2c and 3.3v lidar
2016-10-20 Remove reference to i2c, likely leftover from merge.
2016-10-20 Add reset signal to brain
    [brain.sch]
2016-10-20 Fixed misspelling in text and added a flowshart and a picture of unit
2016-10-20 Added a new version of flow shart about funktionality and added pictures to LaTex dokument
2016-10-20 Added LP-filter to the flow shart over sensors
2016-10-24 Fix label to sensorenhet
2016-10-24 UART > interrupt for emergency brake
2016-10-24 Update merged drawing with new sensorenhet
2016-10-24 Remove duplicate image of sensor placement and ref to appendix instead
2016-10-24 Reference schematics in intro
2016-10-24 We may be using LIDAR lite v3
2016-10-24 Sensor module does not care about if we follow a wall
2016-10-24 Interrupt to UART
2016-10-24 Remove incorrect flowchart
2016-10-24 We dont have brakes. Stop motor instead
2016-10-24 I2C comparision does no longer exist. Remove link to it.
2016-10-24 Changes to buttons/switches
2016-10-24 Sensor reading/sending clarifications
2016-10-24 Single threaded styrenhet
2016-10-31 Updated time plan and report
    [tidsplanering_current.xls]
2016-10-31 Fixed rounding error
    [tidsplanering_current.xls]
2016-10-31 Fixed style and formatting
    [tidsplanering_current.xls]
2016-10-31 Fixed formatting errors, and modified time plan
    [tidsplanering_current.xls]
2016-10-31 Added missing info
    [tidsplanering_current.xls]
2016-11-03 Updated meeting time for week 44
    [tidsplanering_current.xls]
2016-11-03 GND>+5v (pdf)
2016-11-04 Implemented UART
2016-11-04 Fix uart connection in kicad
    [sensorenhet.sch, styrenhet.sch]
2016-11-05 UART working
2016-11-05 Moved UART functionality from Styrenhet.c, added simple example of UART communication
2016-11-05 Add uart lib and test script
2016-11-05 Fix uart transmission fÃor numbers under 10
    [UART.py]
2016-11-05 Implemented receiving whole UART messages
2016-11-05 Stresstest, bugfixes, and increase bytes for packet size.
    [communication.py]
2016-11-06 Fix docstrings for ip connection functions
    [client.py, communication.py, server.py]
2016-11-06 PWM interface implemented.
    [tidsplanering_original.xls]
2016-11-06 Created away for the module to recive data from IR an gyro
2016-11-07 made some adjustments to sensorenhet
2016-11-07 Add function to decode metapackets from UART
2016-11-07 Make bluetooth more package friendly. Rename folder to avoid name collisions with pybluez. Chane test to be run from python3 interpreter.
    [client.py, communication.py, server.py]
2016-11-07 Add documentation for UART functions
2016-11-07 Added functionality for reading the voltage from 4 IR sensors.
2016-11-08 Fix imports and refused connection on raspbian
    [client.py, communication.py, main.py, server.py]
2016-11-08 Sends uart input data to PC
2016-11-08 Add UART functionality.
2016-11-08 Voltage to centimeters.
2016-11-08 Added motor functions as well as added in the UART functions for experimental purposes and with future adjustments to use for communicating motor commands
2016-11-08 Updated UART library
2016-11-08 Implemented functionality for reading data from the LIDAR sensor
2016-11-09 Calibrated LIDAR sensor and changed names to coding standard
2016-11-09 Added UART enums for engine module and implemented some handles for UART commands
2016-11-09 Add simple socket client
2016-11-10 Can set motor sliders. Radiobutton selected by default
2016-11-10 Fix send commands to server4
    [main.py]
2016-11-10 Working example of sending command via WIFI and realying over UART. UART seems unstable.
    [UART.py, robot_communication.py]
2016-11-10 Added prel. functions for all general UART command communication
2016-11-10 Code for gyro.
2016-11-11 Map drawing prototype
2016-11-11 UART 2.0
2016-11-11 Added all current commands for server -> styrenhet
2016-11-11 Updated controller functions to be used with the new lists, also added a potential function to be used for getting controller data, with return parameters specified. It does however require server-si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
2016-11-11 Fixed some indentation and tabs, added enum for GET_DIAG currently not implemented
    [UART.c, UART.h]
2016-11-13 Added GetExecutableFunction in modules.py to get a runnable motor function from a function number and a dict with parameters. Also fixed some errors in the definitions of said motor functions. Beware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
2016-11-13 Working calibration test, a decent GAIN value.
2016-11-13 Simple UART loop.
2016-11-14 Separated Styrenhet into .c and .h files (documentation still TODO). Also fixed some syntax errors that would have caused trouble during runtime.
    [Styrenhet.c, Styrenhet.h]
2016-11-14 Revised time plan efter week 45
    [tidsplanering_current.xls, tidsplanering_original.xls]
2016-11-14 Code cleaning sensorenhet
2016-11-14 Changed parameters irOutputToCentimeters and lidarOutputToCentimeters, to getIrDistance and getLidarDistance
2016-11-14 Fixed comments in sensorenhet
    [sensorenhet.h]
2016-11-14 Moved device-specific code to separate file
2016-11-14 Revert "Moved device-specific code to separate file"
    This reverts commit f883a9099f73a9b742c1daa7a333c119667ce3e2.
    [Communication.c, Communication.h]
2016-11-14 Change enum to incorporate sensor.
2016-11-14 Extend encode/decode to sensor values.
2016-11-14 Remove no longer relevant comment.
    [Communication.c]
2016-11-14 Remove old UART files.
2016-11-14 Implement sensor communication.
2016-11-15 Working sensor server.
2016-11-15 Enable interrupts.
2016-11-15 Improve LIDAR resolution.
2016-11-15 fixed some imports, changed some enums for the new uart lib
    [Communication.c, Communication.h, Styrenhet.c, Styrenhet.h]
2016-11-15 Fix a bug where an ACK was no longer sent.
    [Styrenhet.c]
2016-11-16 Changed "msgTypeToSensor" from return type int to sensor_t
2016-11-16 Fixed signed/unsigned problem between Pi and sensorenhet.
    [sensorenhet.c]
2016-11-16 Changed some coding mistakes.
    [sensorenhet.c]
2016-11-16 Turning calibration test file.
2016-11-17 Add demo measurement data from lidar swipe
2016-11-17 Fixed documentation for all functions in styrenhet
    [Styrenhet.c, Styrenhet.h]
2016-11-17 Fix a bug where quitting would result in a crash.
    [main.py]
2016-11-17 Adjusted constant for gyro.
2016-11-17 Made wrong config on gyro constant, is right now.
    [sensorenhet.c]
2016-11-18 Added super-generic basic PID class
2016-11-18 Removed debug print. Documentation.
2016-11-18 Fixed wrong sign in output. Set fixed sample time.
    [pid.py]
2016-11-18 Reset windup mitigation. Bug fixes
    [pid.py]
2016-11-18 Added some handling for IR sensors to dict in rpi
2016-11-18 Added func for getting gyro as well as all the other sensors into the dict
2016-11-18 All current commands for sensors and controller (should) now be fully functional in robot_communication.py (by adding the values to a dict. Handling different types of commands should be easy enough 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
2016-11-19 Added basic PID test with mock data
2016-11-19 Fixed files missing from merge
    [command.py, communication.py]
2016-11-19 Fixed one small spelling misstake
    [map.py]
2016-11-20 Took away a TODO, since I fixed it to prev commit
    [map.py]
2016-11-20 Working, but somewhat wobbly
    [follow_wall.py]
2016-11-21 Revised time plan for week 46
    [tidsplanering_current.xls]
2016-11-21 fixed sides in styrenhet.c
    [Styrenhet.c]
2016-11-21 Fixed missing semicolon (sorry!)
    [Styrenhet.c, Styrenhet.h]
2016-11-21 Made sure that robot_communications.py worked for motors worked with manual control.
2016-11-22 Remove movement on-screen buttons.
2016-11-22 Add servo angle scale.
2016-11-22 Move frames around.
2016-11-23 Comment uart back in.
2016-11-23 Added some fixed for the collecting of all posible grid -> grid taht the robot can take
    [map.py]
2016-11-23 Corrected an error in creating the list of all posible grid -> grid ways
    [map.py]
2016-11-23 Fixed an small error in plttoing funktions
    [map.py]
2016-11-23 Average 5 IR/Lidar values before sending response
2016-11-23 Updated PID after changes in sensorenheten. Turning test contains implementation off follow_wall.
2016-11-23 Dont average lidar values
2016-11-24 Added functional threading for wifi on rpi.
2016-11-24 Revert "Added missing constructor"
    This reverts commit e32154256c186817158beabbb5050a789e4fc32d.
    [command.py]
2016-11-24 Add soft shutdown button library support.
2016-11-25 Revert "Can now set number of measurements in IR commands."
    This reverts commit 8522e0509a77aea319ba924397c2c360dd66d5ca.
    [command.py, communication.py]
2016-11-25 Changed steering with double keys as well as adjusted the speeds
2016-11-25 Fix no waiting on process_actions.
    [robot_communication.py]
2016-11-26 Get buttons working again.
2016-11-26 Fixed mode switching for PC -> rpi, Switch -> rpi
    [main.py, mode.py, robot_communication.py, robot_wifi.py]
2016-11-26 Revert "fixed wrong indentation"
    This reverts commit de2dfbd969102b4e6774d7cbdf87ae3b64335149.
    [main.py]
2016-11-26 Fixed function name and wrong indentation
    [main.py, mode.py, robot_communication.py]
2016-11-26 Fix high gui cpu usage
    [main.py]
2016-11-26 Fixed incorrect UART init
    [robot_communication.py]
2016-11-26 Removed UART sleep
2016-11-26 Calibrated servo for lidar, now it is more precise. Made the servo reset at 90 degrees.
    [Styrenhet.c]
2016-11-26 Fix scan for increased baud rate. List input split into multiple arguments
    [map.py]
2016-11-26 Calibrate sleeps. Remove comment based version control and debug prints.
2016-11-26 Removed (probably) unneeded lock, fixed gyro PWM -> Angle calculation
    [robot_communication.py, robot_wifi.py]
2016-11-26 Add GridMap class. Attempt at converting lines to GridMap - fail.
    [grid_map.py, map.py]
2016-11-27 Add a cast to avoid errors when floats are sent.
    [UART.py]
2016-11-27 Replace Gyro with i2c-based MPU-6050
    [sensorenhet.c, sensorenhet.h]
2016-11-28 Fixed get_size and also satrted making changes on how to represent cells
    [map.py]
2016-11-28 Gyro is calibrated for the new.
2016-11-28 Readd bias calibration
2016-11-29 Implement median, remove left corridor case (what we have now covers it), some adjustments.
2016-11-29 Minor revision
    [tidsplanering_current.xls]
2016-11-30 Add some new code for mapping and how to handle grids, there is soem problem with changing a cell properties
    [map.py]
2016-11-30 Wall following working with test maze. Now using LIDAR to determine travel distance before/after turn.
2016-11-30 Fix an oversight where coordinates for any certain cell would change on expansion.
    [grid_map.py]
2016-12-01 Fix gyro conversion to centigrades/s
    [sensorenhet.c]
2016-12-01 Fix gyro conversion. Make robot.turn take a speed. Add function to stand perpendicular to a wall
    [follow_wall.py]
2016-12-01 Fix left side stand_perpendicular
    [follow_wall.py]
2016-12-01 Add initial technical documentation
    [brain.kicad_pcb, brain.sch, sensorenhet.kicad_pcb, sensorenhet.sch, styrenhet.kicad_pcb, styrenhet.sch]
2016-12-01 Remove old debug print.
2016-12-01 Now accepting USB devices as command-line arguments. Documentation and formatting.
2016-12-01 Documentaion, fixed out-commented lines leftover from test.
    [follow_wall.py]
2016-12-01 Replace gyro in schematics
    [sensorenhet.sch]
2016-12-03 Fix sensor reading using wrong packet as metapacket. Add (optional) port arguments to init_UART
    [robot_communication.py]
2016-12-03 Replace sleeps with movement checks. Stand perpendicular after turns
    [follow_wall.py]
2016-12-03 Drive_distance will return false instead of driving into walls, if an obstacle appears. Will also stop motors before returning.
2016-12-03 Check if the corridor detection was a false positive before turning. Drive a full square into the corridor otherwise, to have something to calibrate with.
2016-12-03 Remove stand_perpendicular for corridors, since it doesn't work very well.
    [follow_wall.py]
2016-12-03 Fix lidar scan speed
    [follow_wall.py]
2016-12-04 Fixed that all coordinates get right type, fixed that che k_available_grid gives the right values and also did test taht these things worked, maybe should change that it doesn't change to open on tha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
    [grid_map.py, map.py]
2016-12-04 Communication and sensor-unit descriptions updated
2016-12-04 UART instruction list done
2016-12-04 Revised time plan.
    [tidsplanering_current.xls]
2016-12-05 Fixed some buggs abd improved
    [grid_map.py, map.py]
2016-12-05 Added PWM details. Minor component updates and added referenses.
2016-12-05 Right corridor calibrations
2016-12-06 Added stop_motors when changing from manual, added sensor data output to pc
2016-12-06 Fixed so that keys are reset when we change to autonomous mode
    [robot_communication.py, robot_wifi.py]
2016-12-06 Removed sneaky symbol that gave syntax error
    [robot_communication.py]
2016-12-06 Fixed yet another sneaky symbol
    [robot_communication.py]
2016-12-06 Testing an os-unspecific fix for keypresses
    [gui.py, main.py]
2016-12-06 Fixed some syntax errors, removed a print
    [robot_communication.py, robot_wifi.py]
2016-12-06 Added GUI components for handling display of sensor values, fixed some incorrect variable names and changed some placement inside gui. Also removed some old code that wasn't used.
    [gui.py, main.py]
2016-12-06 handle_command now returns the sensor value as well (not for motor control)
2016-12-06 Added source for PID code.
2016-12-06 Fix lidar readings using handle_command
    [robot_communication.py]
2016-12-06 Lidar scan docstring. Don't place servo degree in list
2016-12-06 Integrate uart detection
2016-12-07 Fix a corner case where we'd end up with some UNKNOWN surrounded by OPEN or WALL.
    [grid_map.py, map.py]
2016-12-07 Added functionality for updating sensor values in GUI from command. Added auto-update every 1s for sensor and motor values displayed in GUI.
2016-12-07 Fixed naming of sensor key 'IR_LIDAR' to 'LIDAR'
    [robot_communication.py]
2016-12-07 Fixed missing .set function call
    [gui.py]
2016-12-07 Detected wifi problems where sending packets would be undetermenistic, fix is half-way
    [main.py, robot_wifi.py]
2016-12-07 Detected wifi problems, fix is half-way
    [communication.py, gui.py, main.py]
2016-12-08 Add docstrings for geometry methods missing them.
    [geometry.py]
2016-12-08 Add wheel sensor support
2016-12-08 Implemented functionality for reflex sensors.
2016-12-08 Added a wrapper function that uses delimiter for socket.sendall
2016-12-09 Improve sensorunit section.
2016-12-09 Fixed communication and thread.Locks
    [communication.py, robot_communication.py, robot_wifi.py]
2016-12-09 Fixed communication so that it uses a buffer
    [communication.py]
2016-12-09 Fix a bug where mm coordinates was used as grid indices.
    [map.py]
2016-12-09 Reflex sensors now sends data in mm.
2016-12-11 Fixed rounding of motor values, fixed timed updates of motor values
    [main.py, robot_communication.py]
2016-12-11 Updated PID chapter.
2016-12-11 Made printing origin optional.
2016-12-11 Fix a bug where bottom_right was (1, 1) too large.
    [grid_map.py]
2016-12-11 Fixed docstrings in mode.py
    [mode.py]
2016-12-11 Fixed spelling, added line for distance
    [gui.py, main.py]
2016-12-11 Minor changes in sensor hardware.
2016-12-11 Fixed incorrect constant for PWM->SpeedPercentage calculation
    [robot_communication.py]
2016-12-12 Removed unnecessary prints.
2016-12-12 Fix a bug where accessing negative indices just after init could get weird.
    [grid_map.py]
2016-12-12 Replace map-creation method in follow_wall. Use autodetection for UART ports.
    [follow_wall.py]
2016-12-12 Removed prints, fixed scaling for servo angle
    [gui.py]
2016-12-12 Fix walls on single-wall-corridor-corners
    [map.py]
2016-12-12 Updated refresh rate of sensor/motor values
2016-12-12 Added a function for clearing the input buffer, as well as made receive_data throw an error when other socket terminates the connection.
    [communication.py]
2016-12-12 Cleaned up the thread initations. Changed some function names to better reflect what they do. Added polling for mode-switching as a separate thread
2016-12-12 Updated syncing speed. Added so that sensor data is synced as well. Mode switching by button is now done seperately by a polling thread
2016-12-12 Added sensor_dict support for reflex sensors
2016-12-12 Added timeout for socket connection. Added handling to recover from socket errors, meaning that the socket will reconnect when the client attempts to, without crashing the program on the robot.
    [robot_wifi.py, server.py]
2016-12-12 Add direction from a position. Fix dumb roundings for positions.
    [geometry.py]
2016-12-12 Fix walls on single-wauu-corridor-corners v2.0. (At least for available test cases)
    [map.py]
2016-12-13 Switched to recommended layout.
2016-12-13 Remove debug prints.
2016-12-13 Remove debug prints. Fix position comparisions.
    [geometry.py, map.py]
2016-12-13 Added reflex sensors to GUI
2016-12-13 Added reflex sensors to text and images.
2016-12-13 Sensorenhet renskriven.
2016-12-13 Fix navigation flowchart.
2016-12-13 Add full mapping/navigation flowcharts.
2016-12-13 More island filtering.
2016-12-13 Add capacitor and resistor values. Add reflex sensors. Add analog filter
    [sensorenhet.sch]
2016-12-13 Fix UART in pdf for styrenhhet
2016-12-13 Edited "Lägesstyrning" flowchart.
2016-12-13 Updated gyro in block diagrams.
2016-12-14 subsubsecion{LIDAR} is updated
2016-12-14 Updated WIFI flowchart.
2016-12-14 Commented out currently non-function setters for reflex sensors
2016-12-14 Added SYNC_MODE to pc wifi, started editing on PWM for styrenheten, added updated GUI picture gui_reflex.png
2016-12-14 Made the descriptions for PWM in styrenhet more in-depth.
2016-12-14 Changed tempus in sensorenhet mjukvara
2016-12-14 Robot, now with reverse gear.
2016-12-14 Added motordiag to systemöversikt
2016-12-14 Fix calibrations for driving with IR in front
    [follow_wall.py]
2016-12-14 Fix calibrations for driving with IR in front. V2.0
    [follow_wall.py]
2016-12-14 Island checks without turning LIDAR.
2016-12-15 Fix a bug where cul-de-sacs didn't get walls if the robot simply turned.
    [map.py]
2016-12-15 Added sync_mode, fixed reflex, added testcase for gridmap, added robot position to SEND_MAP data
    [robot_communication.py, robot_wifi.py]
2016-12-15 Added SYNC_MODE, reflex sensor update and SEND_MAP support
2016-12-15 Fixed minor errors in code
    [main.py, robot_communication.py, robot_wifi.py]
2016-12-15 Fixed grid map (added robot pos argument), added random-generated test grid. Added some debug-prints
    [gpio_buttons.py, grid_map.py, mode.py, robot_communication.py, robot_wifi.py]
2016-12-15 Reflex sensor constant
2016-12-15 Minor (probably) calibrations
2016-12-16 Autonomous step do not leave before follow_wall returns. This commit contains code that created the correct map but did not drive home.
    [follow_wall.py, main.py, mode.py]
2016-12-16 Fix incorrect print
2016-12-16 Reworked grid for GUI
    [gui.py, main.py]
2016-12-16 Changed shutdown to mode change, added motor_diag updates in follow_wall. Added distance travelled to sensor_data
2016-12-16 Remove failing stand_perpendicular. Fix safety override.
    [follow_wall.py]
2016-12-18 PD calibrations (nonfunctional)
2016-12-19 Switched to mtTkinter to handle the threaded GUI calls
2016-12-19 Fix mode type for wifi transmission
    [robot_wifi.py]
2016-12-19 Fix incorrect constant placement
    [robot_communication.py]
2016-12-19 Full documentation for dev_pc. Removed old test file. Fixed client.py socket init.
    [client.py, communication.py, gui.py, main.py]
